TheSupremeMonkey/AMC-6502/docs/hardware/photos/mos-6502.jpg

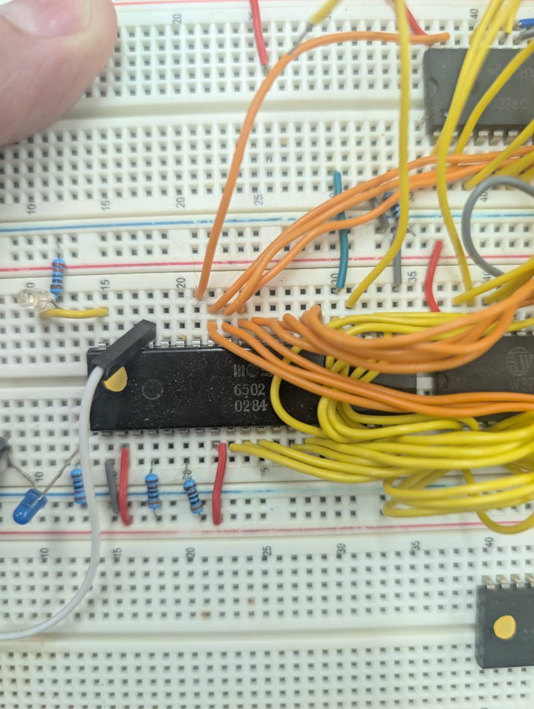
docs/hardware/photos/mos-6502.jpg
