TheSupremeMonkey/AMC-6502/docs/hardware/photos/mos-6522.jpg

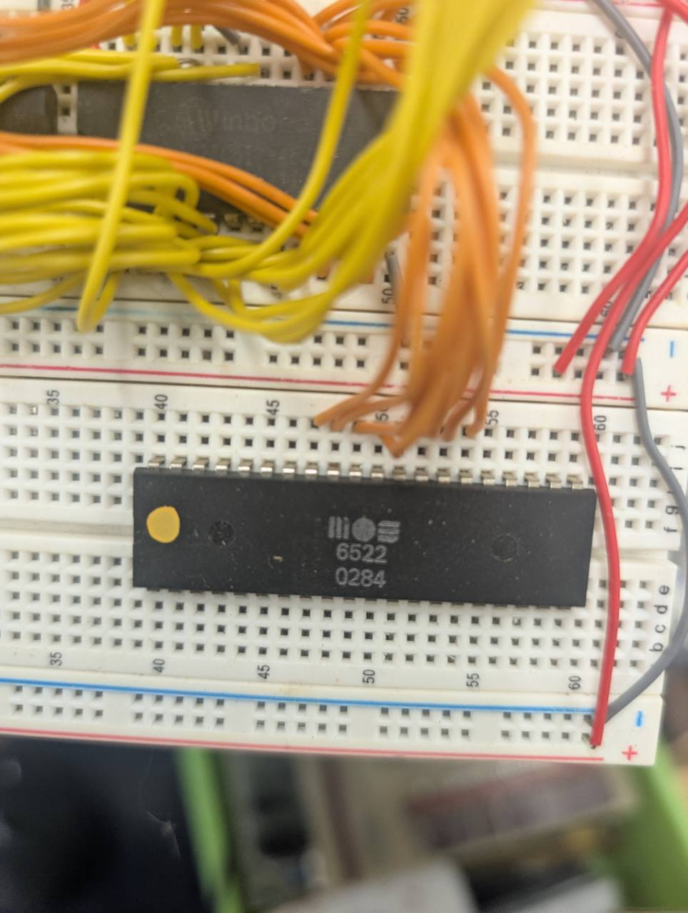
docs/hardware/photos/mos-6522.jpg
