TheSupremeMonkey/AMC-6502/docs/hardware/photos/w27c512-45z.jpg

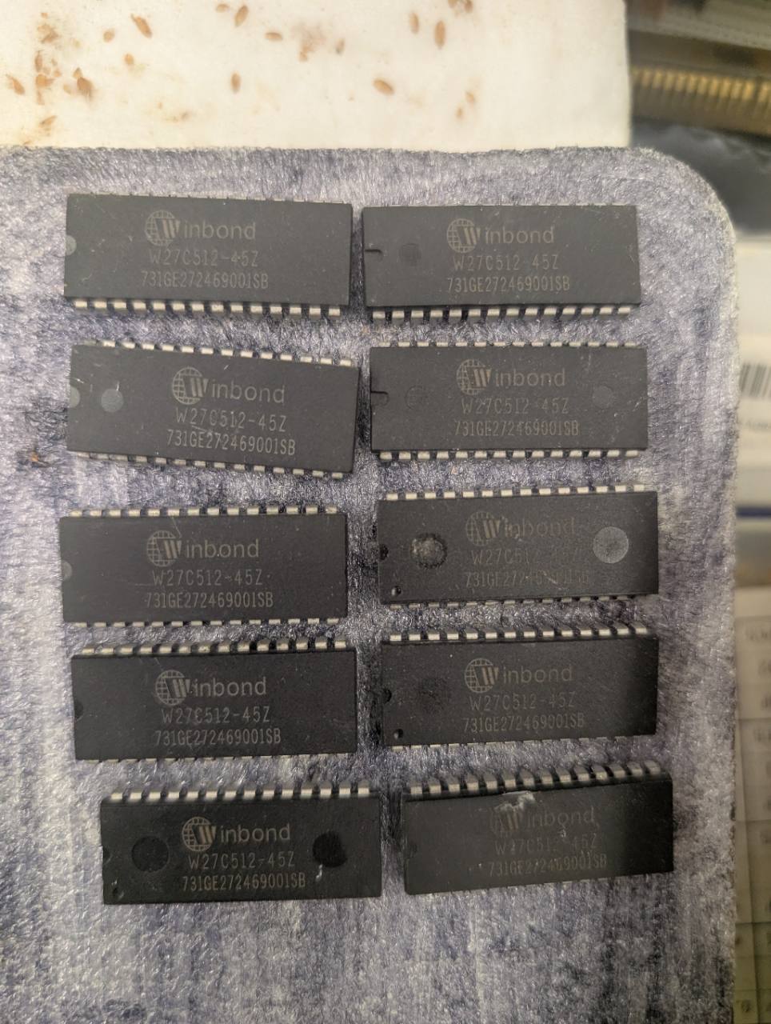
docs/hardware/photos/w27c512-45z.jpg
