TheSupremeMonkey/AMC-6502/hardware/kicad/01_CPU_Memory.kicad_sch

## KiCad design hardware/kicad/01_CPU_Memory.kicad_sch (2026-10-24)

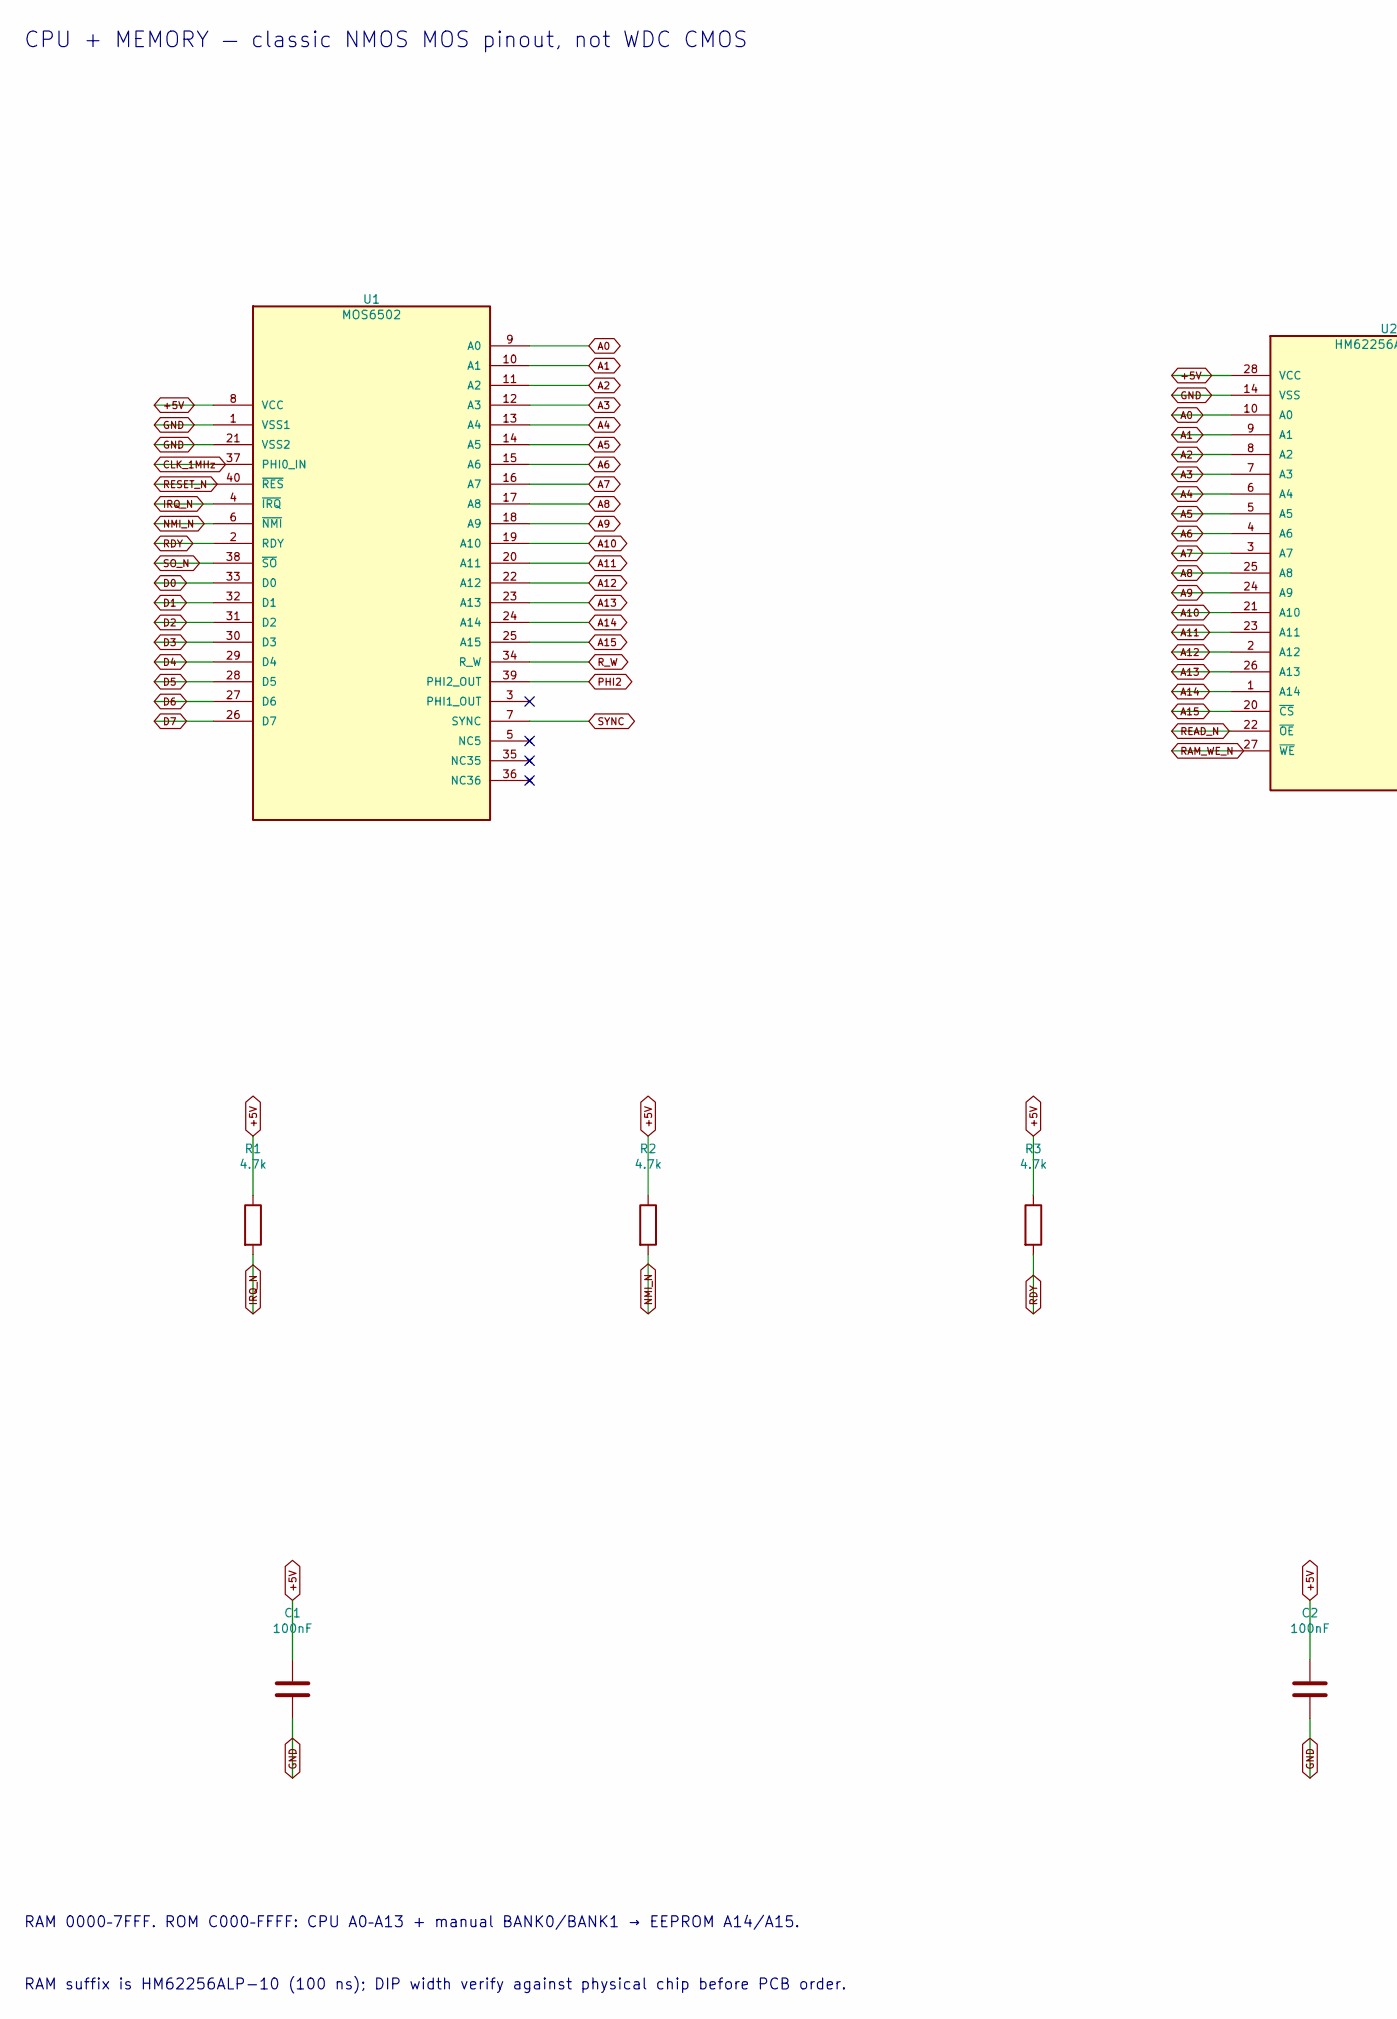
[picture p5: schematic 01_CPU_Memory.kicad_sch, part in row 1, column 1]

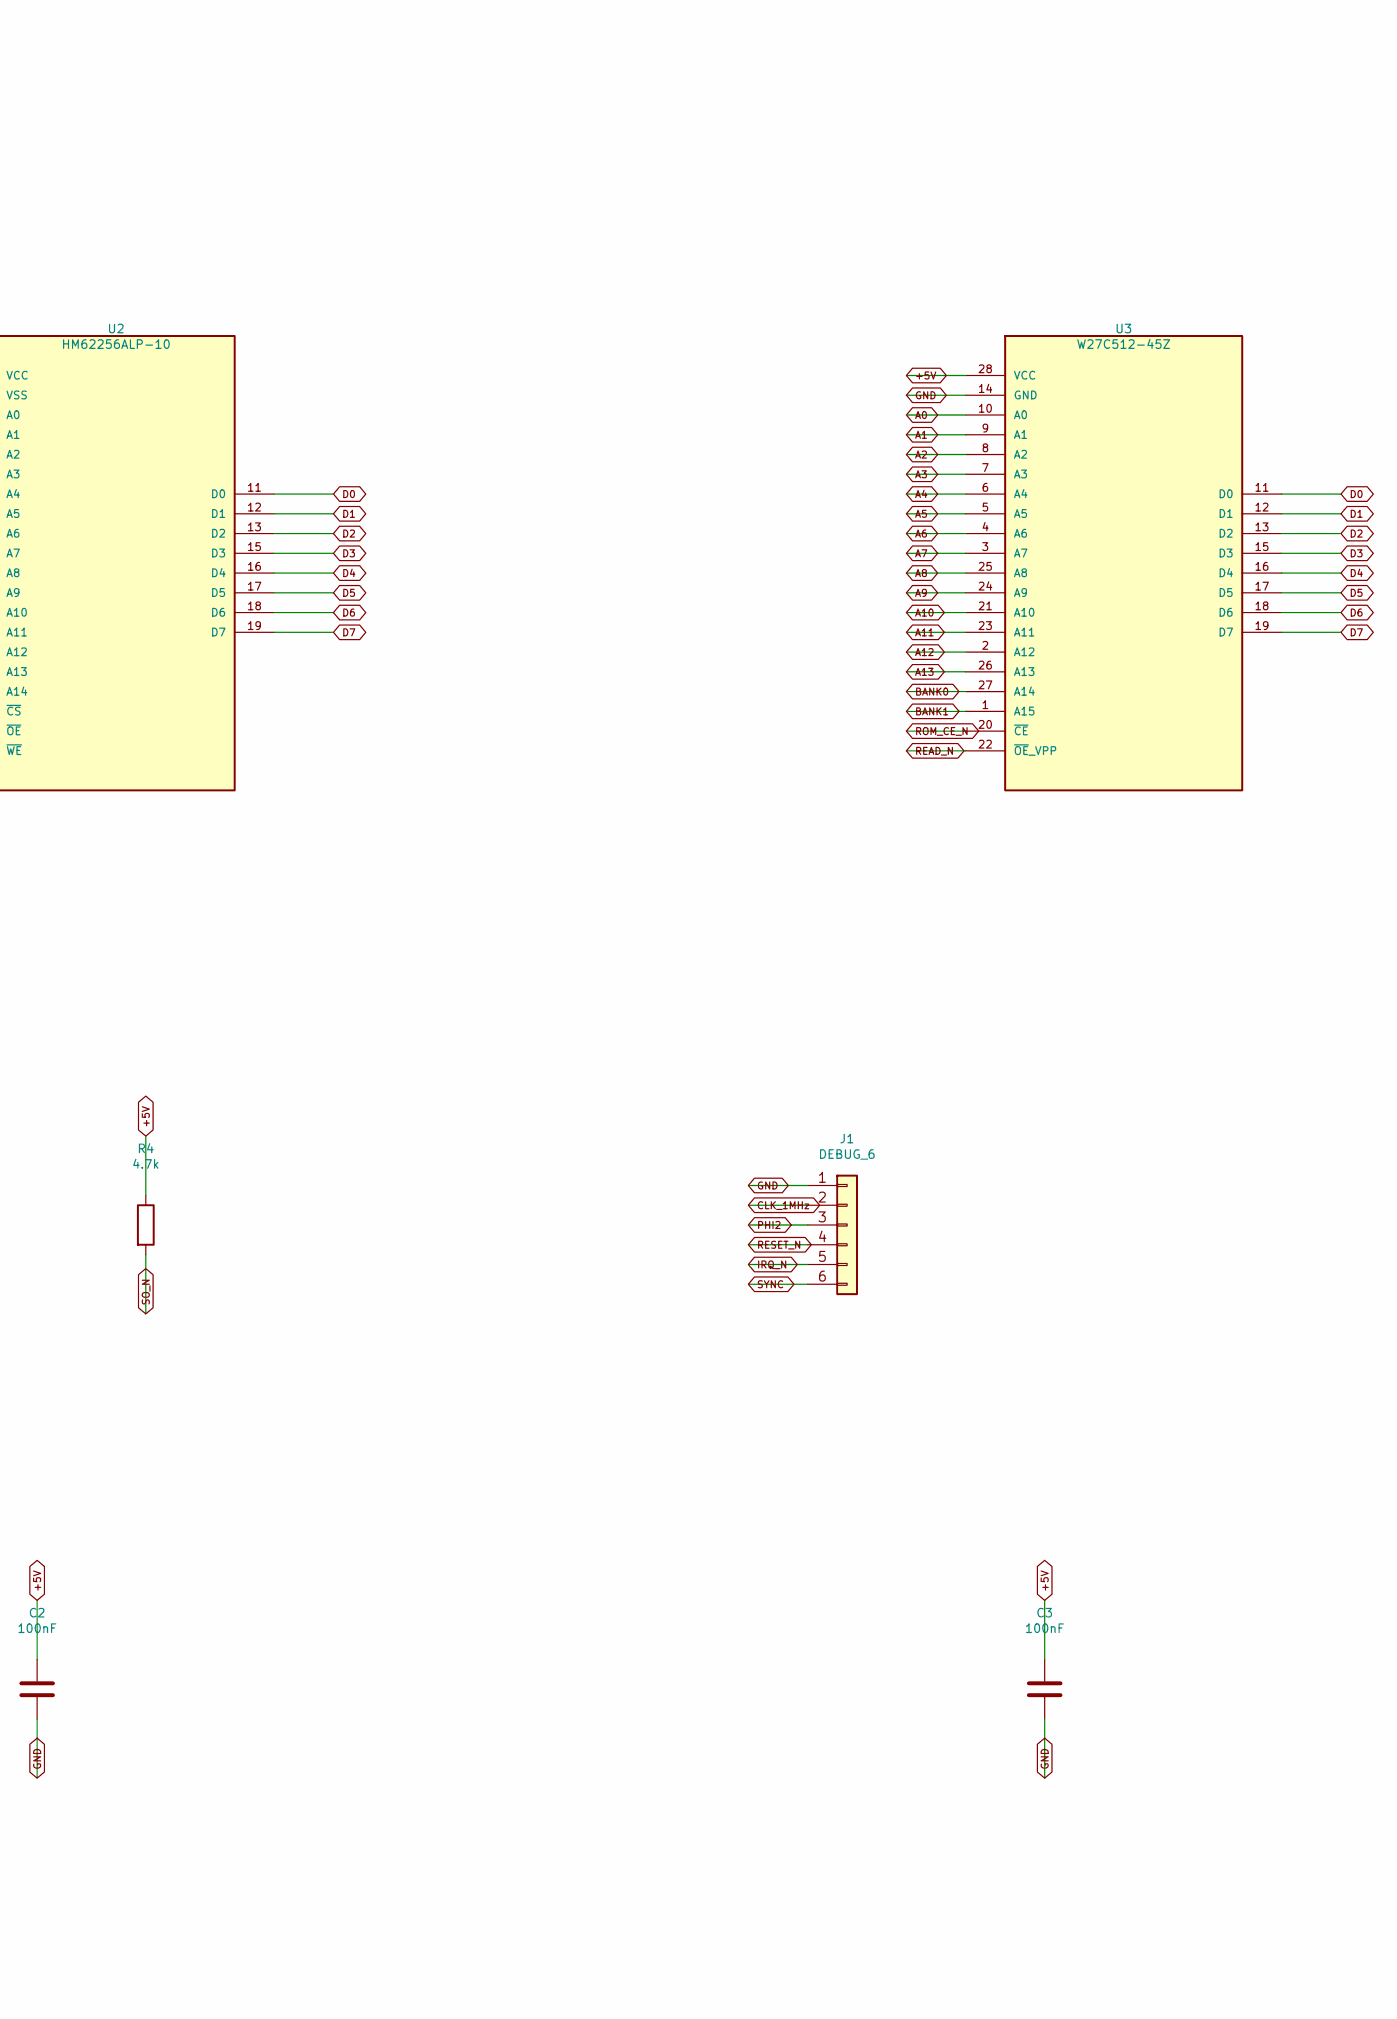
[picture p6: schematic 01_CPU_Memory.kicad_sch, part in row 1, column 2]

Parts:
C1, C2, C3: 100nF; C_Disc_D5.0mm_W2.5mm_P5.00mm
J1: DEBUG_6; PinHeader_1x06_P2.54mm_Vertical
R1, R2, R3, R4: 4.7k; R_Axial_DIN0207_L6.3mm_D2.5mm_P10.16mm_Horizontal
U1: MOS6502; DIP-40_W15.24mm_Socket
U2: HM62256ALP-10; DIP-28_W15.24mm_Socket
U3: W27C512-45Z; DIP-28_W15.24mm_Socket

Connections:
+5V: C1.1, C2.1, C3.1, R1.1, R2.1, R3.1, R4.1, U1.8 (VCC), U2.28 (VCC), U3.28 (VCC)
A0: U1.9 (A0), U2.10 (A0), U3.10 (A0)
A1: U1.10 (A1), U2.9 (A1), U3.9 (A1)
A2: U1.11 (A2), U2.8 (A2), U3.8 (A2)
A3: U1.12 (A3), U2.7 (A3), U3.7 (A3)
A4: U1.13 (A4), U2.6 (A4), U3.6 (A4)
A5: U1.14 (A5), U2.5 (A5), U3.5 (A5)
A6: U1.15 (A6), U2.4 (A6), U3.4 (A6)
A7: U1.16 (A7), U2.3 (A7), U3.3 (A7)
A8: U1.17 (A8), U2.25 (A8), U3.25 (A8)
A9: U1.18 (A9), U2.24 (A9), U3.24 (A9)
A10: U1.19 (A10), U2.21 (A10), U3.21 (A10)
A11: U1.20 (A11), U2.23 (A11), U3.23 (A11)
A12: U1.22 (A12), U2.2 (A12), U3.2 (A12)
A13: U1.23 (A13), U2.26 (A13), U3.26 (A13)
A14: U1.24 (A14), U2.1 (A14)
A15: U1.25 (A15), U2.20 (~CS)
BANK0: U3.27 (A14)
BANK1: U3.1 (A15)
CLK_1MHz: J1.2, U1.37 (PHI0_IN)
D0: U1.33 (D0), U2.11 (D0), U3.11 (D0)
D1: U1.32 (D1), U2.12 (D1), U3.12 (D1)
D2: U1.31 (D2), U2.13 (D2), U3.13 (D2)
D3: U1.30 (D3), U2.15 (D3), U3.15 (D3)
D4: U1.29 (D4), U2.16 (D4), U3.16 (D4)
D5: U1.28 (D5), U2.17 (D5), U3.17 (D5)
D6: U1.27 (D6), U2.18 (D6), U3.18 (D6)
D7: U1.26 (D7), U2.19 (D7), U3.19 (D7)
GND: C1.2, C2.2, C3.2, J1.1, U1.1 (VSS1), U1.21 (VSS2), U2.14 (VSS), U3.14 (GND)
IRQ_N: J1.5, R1.2, U1.4 (~IRQ)
NMI_N: R2.2, U1.6 (~NMI)
PHI2: J1.3, U1.39 (PHI2_OUT)
RAM_WE_N: U2.27 (~WE)
RDY: R3.2, U1.2 (RDY)
READ_N: U2.22 (~OE), U3.22 (~OE_VPP)
RESET_N: J1.4, U1.40 (~RES)
ROM_CE_N: U3.20 (~CE)
R_W: U1.34 (R_W)
SO_N: R4.2, U1.38 (~SO)
SYNC: J1.6, U1.7 (SYNC)

Notes on the sheet:
CPU + MEMORY — classic NMOS MOS pinout, not WDC CMOS
RAM 0000–7FFF. ROM C000–FFFF: CPU A0–A13 + manual BANK0/BANK1 → EEPROM A14/A15.
RAM suffix is HM62256ALP-10 (100 ns); DIP width verify against physical chip before PCB order.
