TheSupremeMonkey/AMC-6502/hardware/kicad/02_Decode_Clock_Reset.kicad_sch

## KiCad design hardware/kicad/02_Decode_Clock_Reset.kicad_sch (2026-10-24)

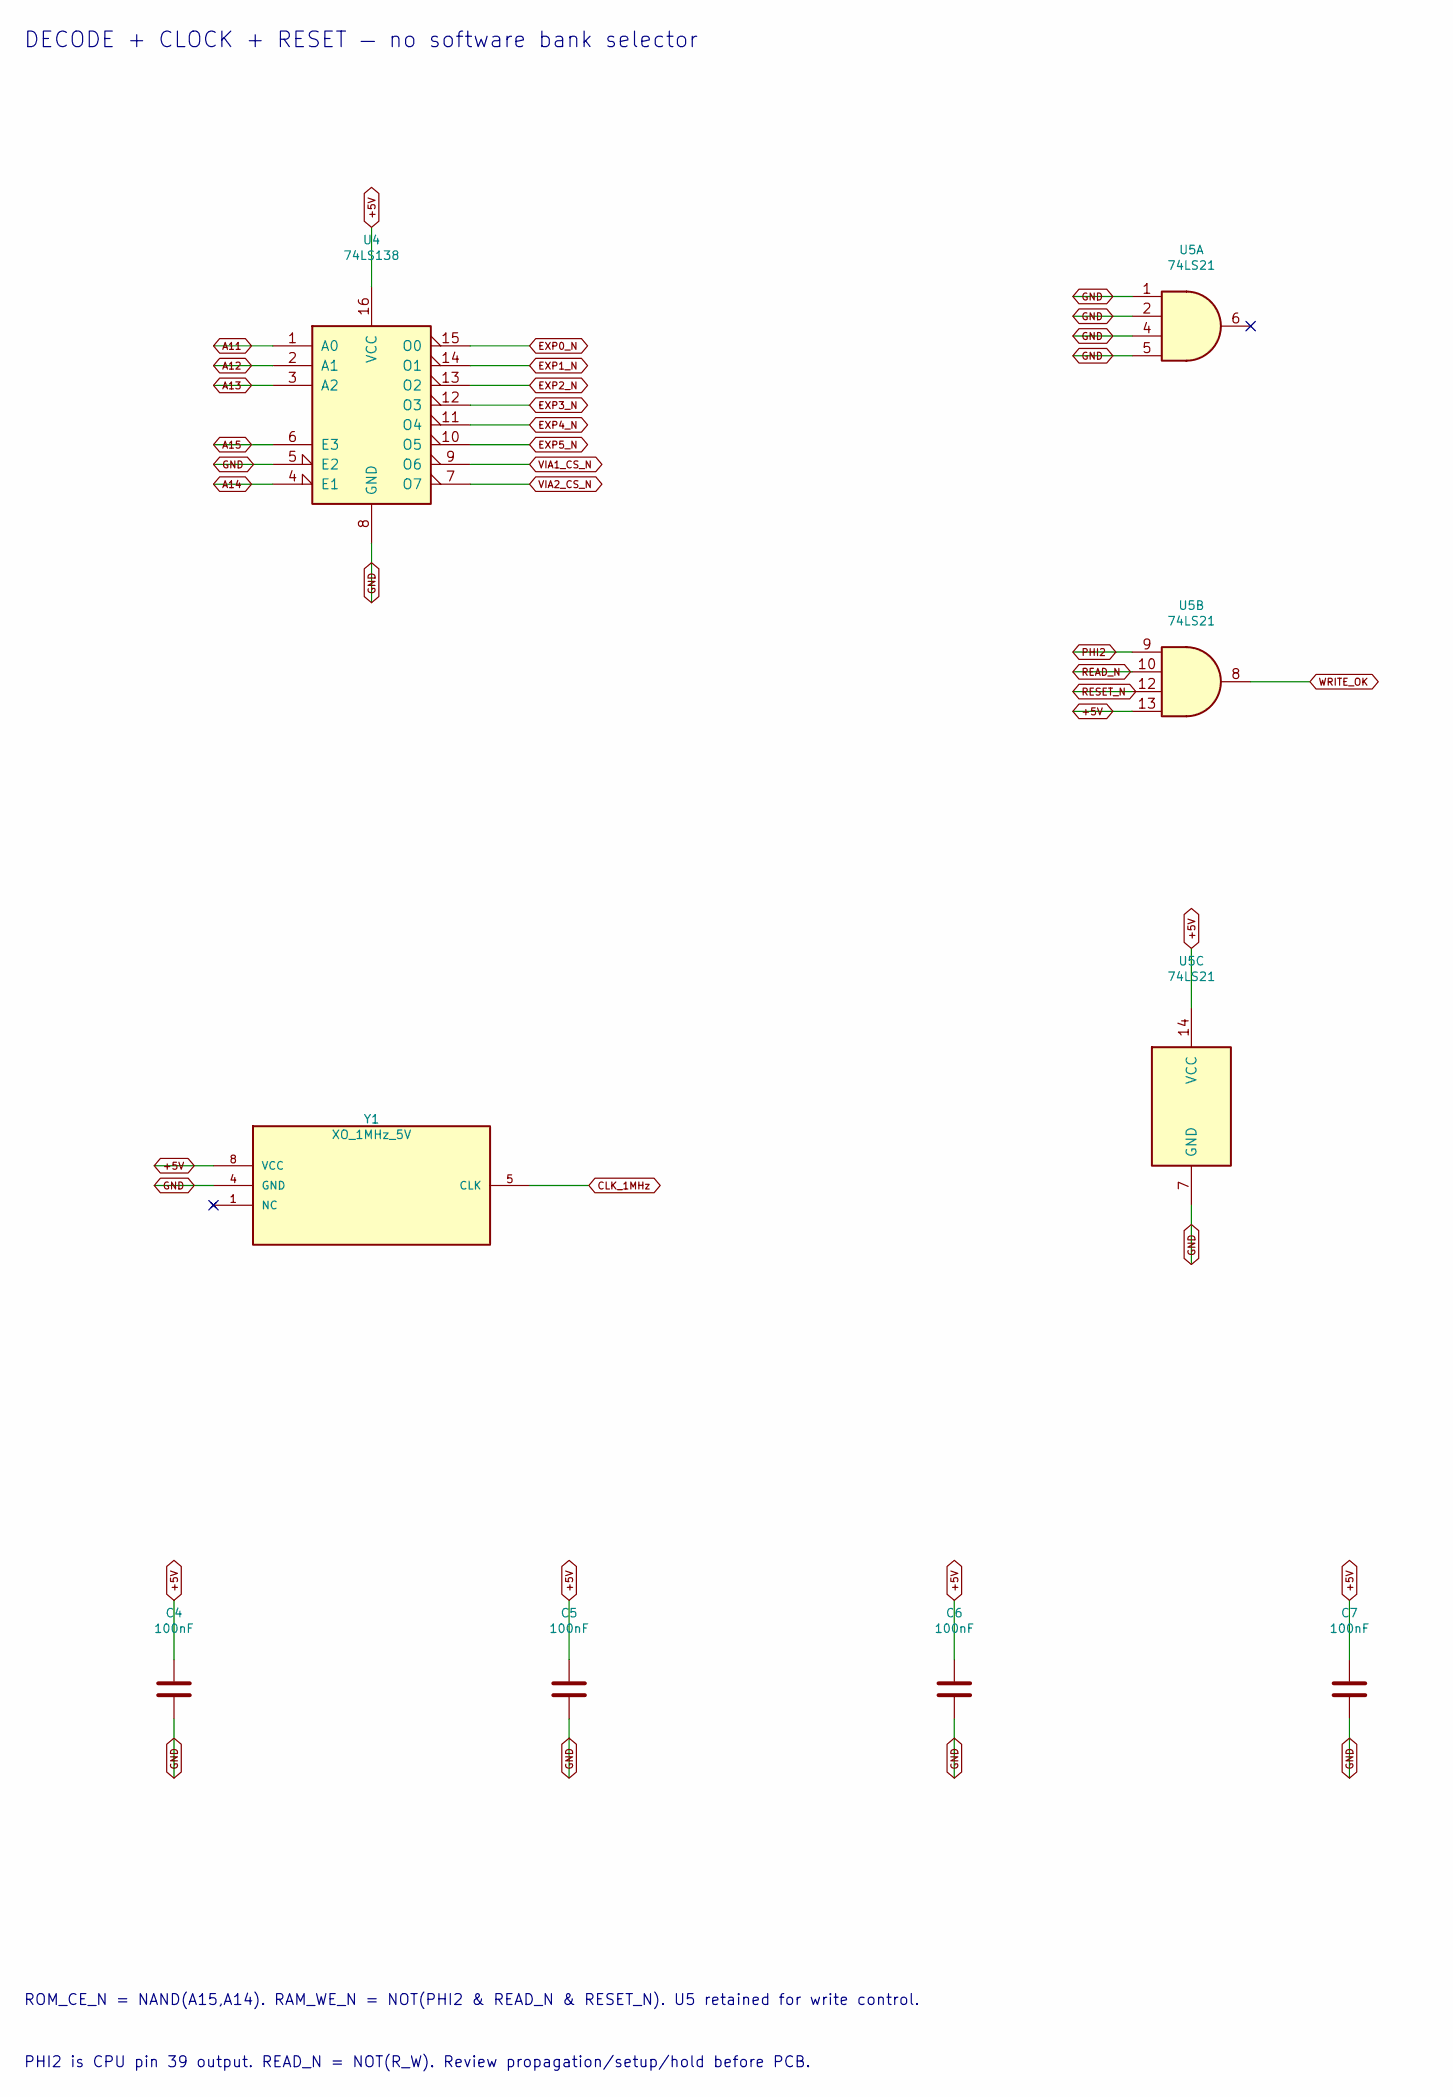
[picture p7: schematic 02_Decode_Clock_Reset.kicad_sch, part in row 1, column 1]

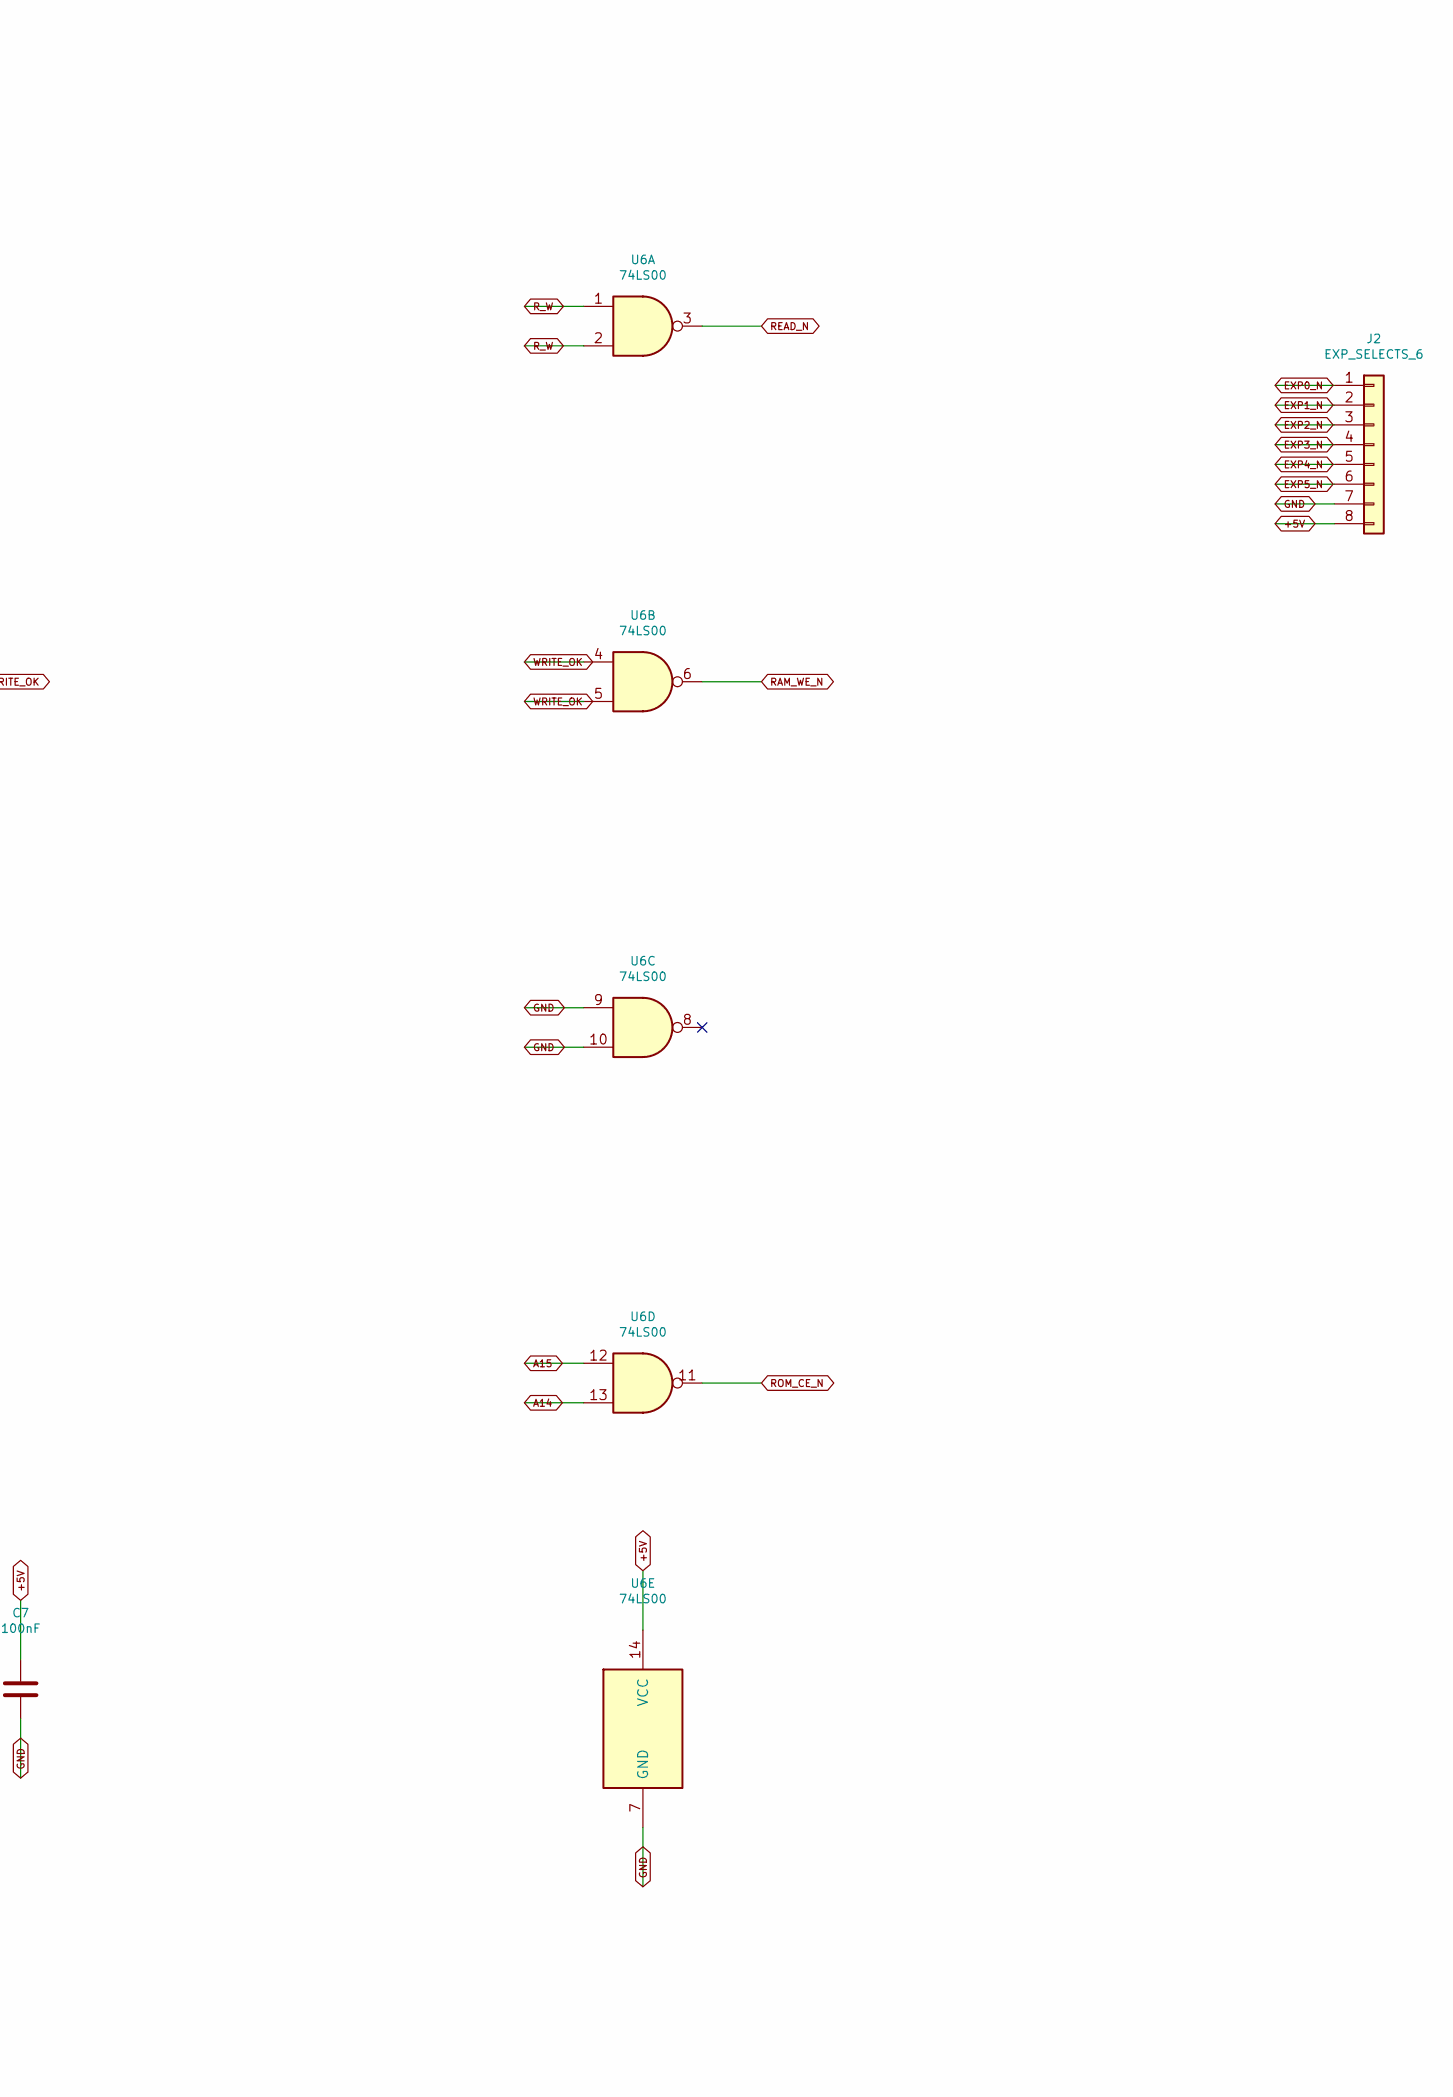
[picture p8: schematic 02_Decode_Clock_Reset.kicad_sch, part in row 1, column 2]

Parts:
C4, C5, C6, C7: 100nF; C_Disc_D5.0mm_W2.5mm_P5.00mm
J2: EXP_SELECTS_6; PinHeader_1x08_P2.54mm_Vertical
U4: 74LS138; DIP-16_W7.62mm_Socket
U5: 74LS21; DIP-14_W7.62mm_Socket
U6: 74LS00; DIP-14_W7.62mm_Socket
Y1: XO_1MHz_5V; Oscillator_DIP-8

Connections:
+5V: C4.1, C5.1, C6.1, C7.1, J2.8, U4.16 (VCC), U5.13, U5.14 (VCC), U6.14 (VCC), Y1.8 (VCC)
A11: U4.1 (A0)
A12: U4.2 (A1)
A13: U4.3 (A2)
A14: U4.4 (E1), U6.13
A15: U4.6 (E3), U6.12
CLK_1MHz: Y1.5 (CLK)
EXP0_N: J2.1, U4.15 (O0)
EXP1_N: J2.2, U4.14 (O1)
EXP2_N: J2.3, U4.13 (O2)
EXP3_N: J2.4, U4.12 (O3)
EXP4_N: J2.5, U4.11 (O4)
EXP5_N: J2.6, U4.10 (O5)
GND: C4.2, C5.2, C6.2, C7.2, J2.7, U4.5 (E2), U4.8 (GND), U5.1, U5.2, U5.4, U5.5, U5.7 (GND), U6.7 (GND), U6.9, U6.10, Y1.4 (GND)
PHI2: U5.9
RAM_WE_N: U6.6
READ_N: U5.10, U6.3
RESET_N: U5.12
ROM_CE_N: U6.11
R_W: U6.1, U6.2
VIA1_CS_N: U4.9 (O6)
VIA2_CS_N: U4.7 (O7)
WRITE_OK: U5.8, U6.4, U6.5

Notes on the sheet:
DECODE + CLOCK + RESET — no software bank selector
ROM_CE_N = NAND(A15,A14). RAM_WE_N = NOT(PHI2 & READ_N & RESET_N). U5 retained for write control.
PHI2 is CPU pin 39 output. READ_N = NOT(R_W). Review propagation/setup/hold before PCB.
