TheSupremeMonkey/AMC-6502/hardware/kicad/03_Reset_Controls.kicad_sch

## KiCad design hardware/kicad/03_Reset_Controls.kicad_sch (2026-10-24)

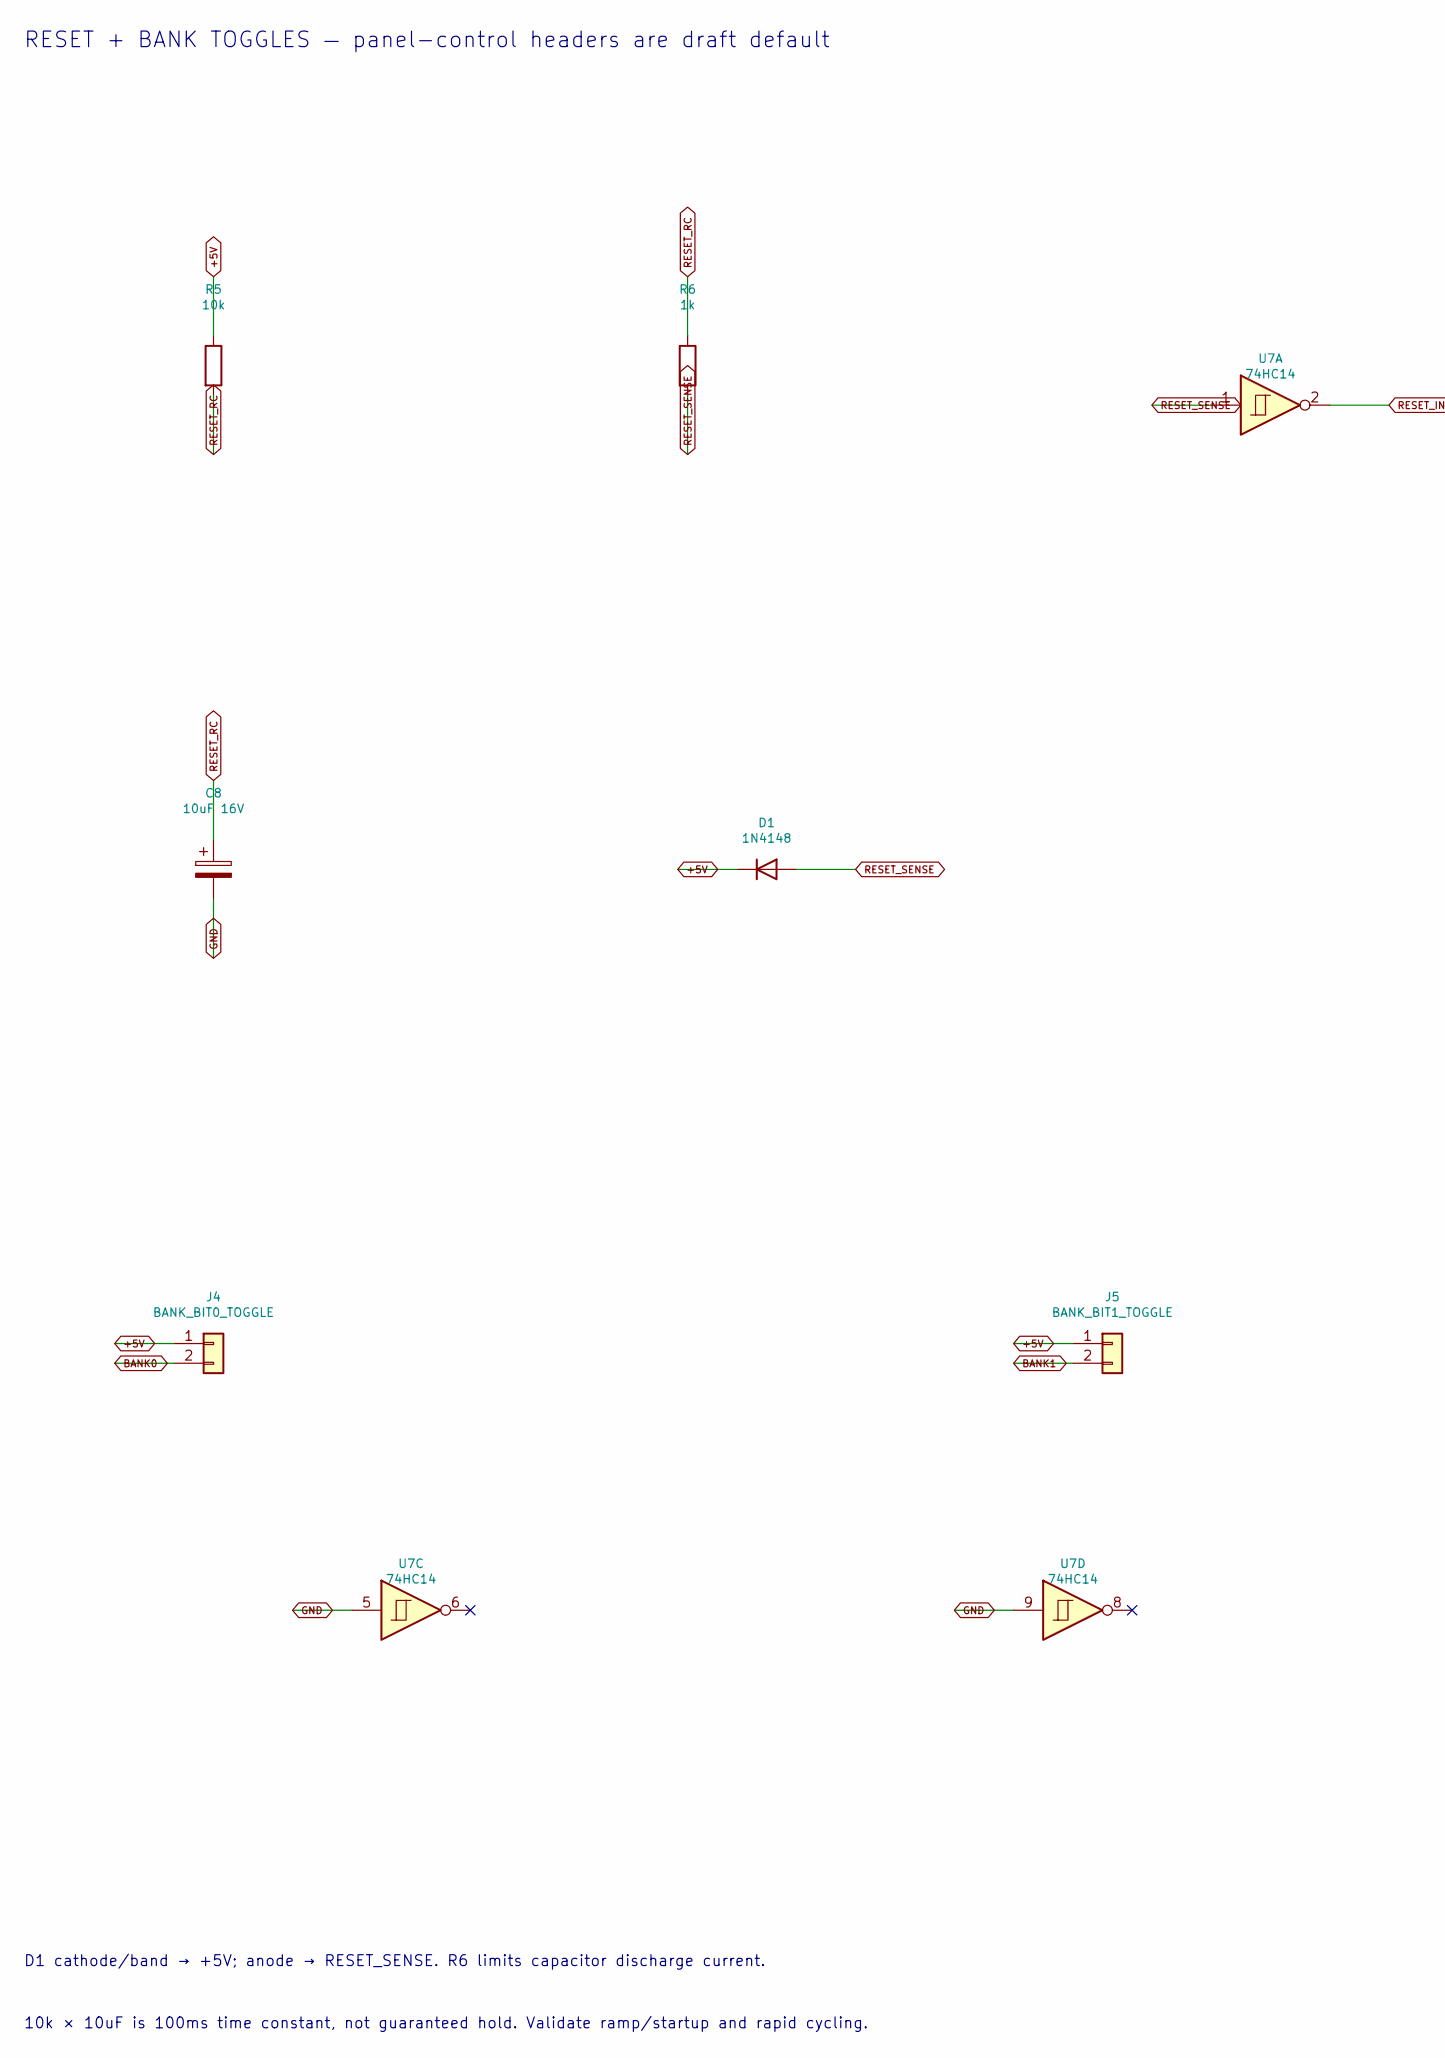
[picture p9: schematic 03_Reset_Controls.kicad_sch, part in row 1, column 1]

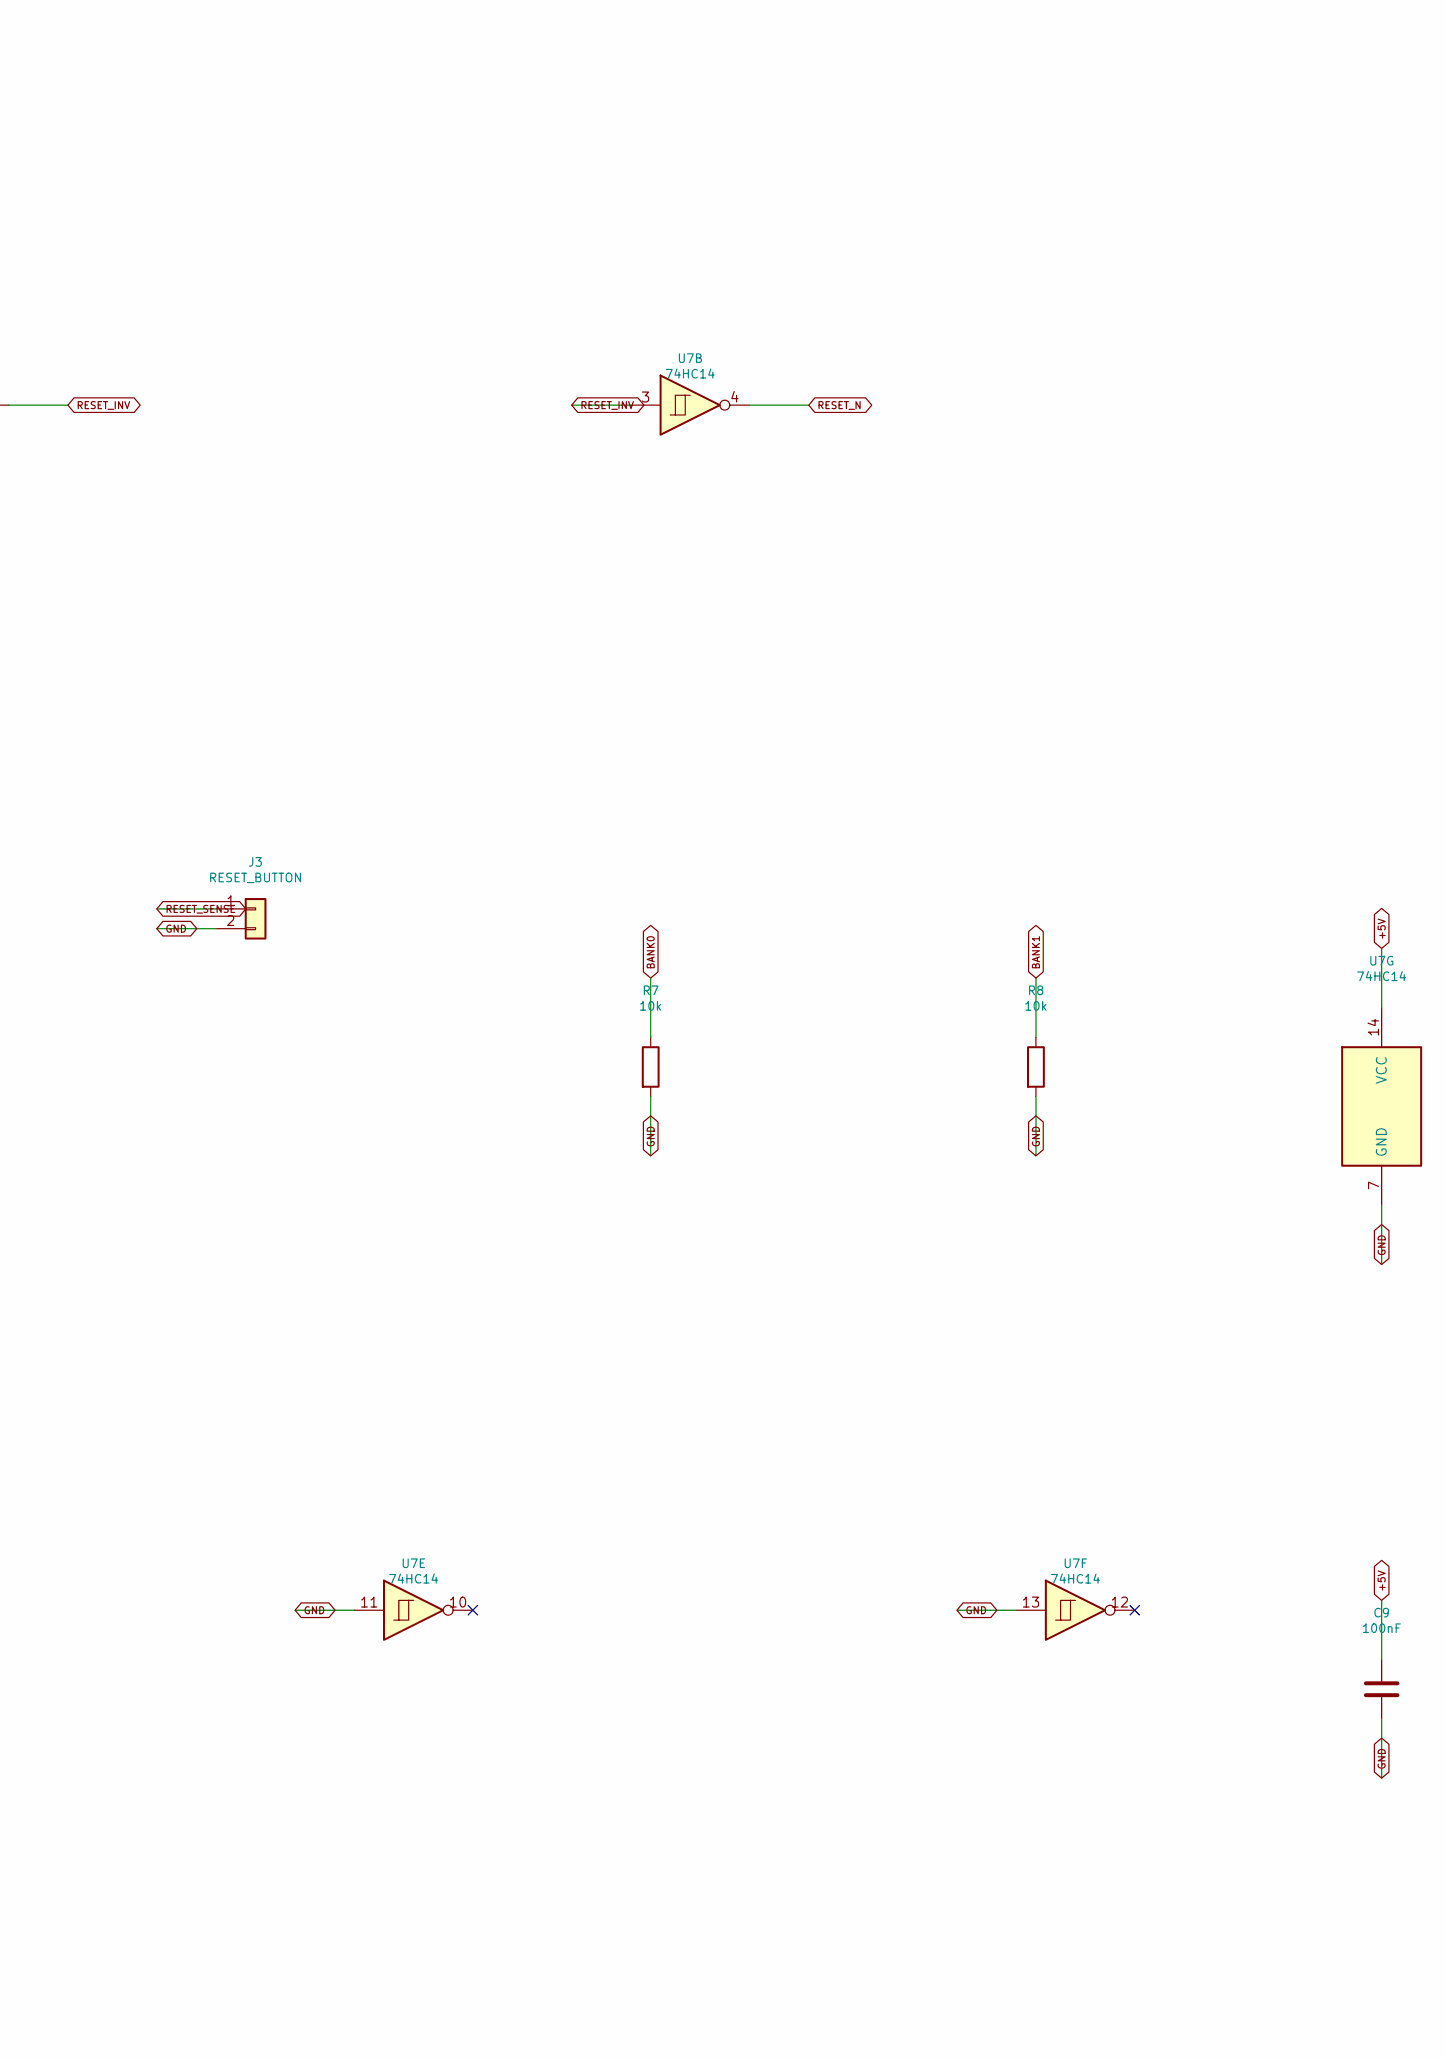
[picture p10: schematic 03_Reset_Controls.kicad_sch, part in row 1, column 2]

Parts:
C8: 10uF 16V; CP_Radial_D5.0mm_P2.00mm
C9: 100nF; C_Disc_D5.0mm_W2.5mm_P5.00mm
D1: 1N4148; D_DO-35_SOD27_P10.16mm_Horizontal
J3: RESET_BUTTON; PinHeader_1x02_P2.54mm_Vertical
J4: BANK_BIT0_TOGGLE; PinHeader_1x02_P2.54mm_Vertical
J5: BANK_BIT1_TOGGLE; PinHeader_1x02_P2.54mm_Vertical
R5, R7, R8: 10k; R_Axial_DIN0207_L6.3mm_D2.5mm_P10.16mm_Horizontal
R6: 1k; R_Axial_DIN0207_L6.3mm_D2.5mm_P10.16mm_Horizontal
U7: 74HC14; DIP-14_W7.62mm_Socket

Connections:
+5V: C9.1, D1.1 (K), J4.1, J5.1, R5.1, U7.14 (VCC)
BANK0: J4.2, R7.1
BANK1: J5.2, R8.1
GND: C8.2, C9.2, J3.2, R7.2, R8.2, U7.5, U7.7 (GND), U7.9, U7.11, U7.13
RESET_INV: U7.2, U7.3
RESET_N: U7.4
RESET_RC: C8.1, R5.2, R6.1
RESET_SENSE: D1.2 (A), J3.1, R6.2, U7.1

Notes on the sheet:
RESET + BANK TOGGLES — panel-control headers are draft default
D1 cathode/band → +5V; anode → RESET_SENSE. R6 limits capacitor discharge current.
10k × 10uF is 100ms time constant, not guaranteed hold. Validate ramp/startup and rapid cycling.
