TheSupremeMonkey/AMC-6502/hardware/kicad/04_VIA_IO.kicad_sch

## KiCad design hardware/kicad/04_VIA_IO.kicad_sch (2026-10-24)

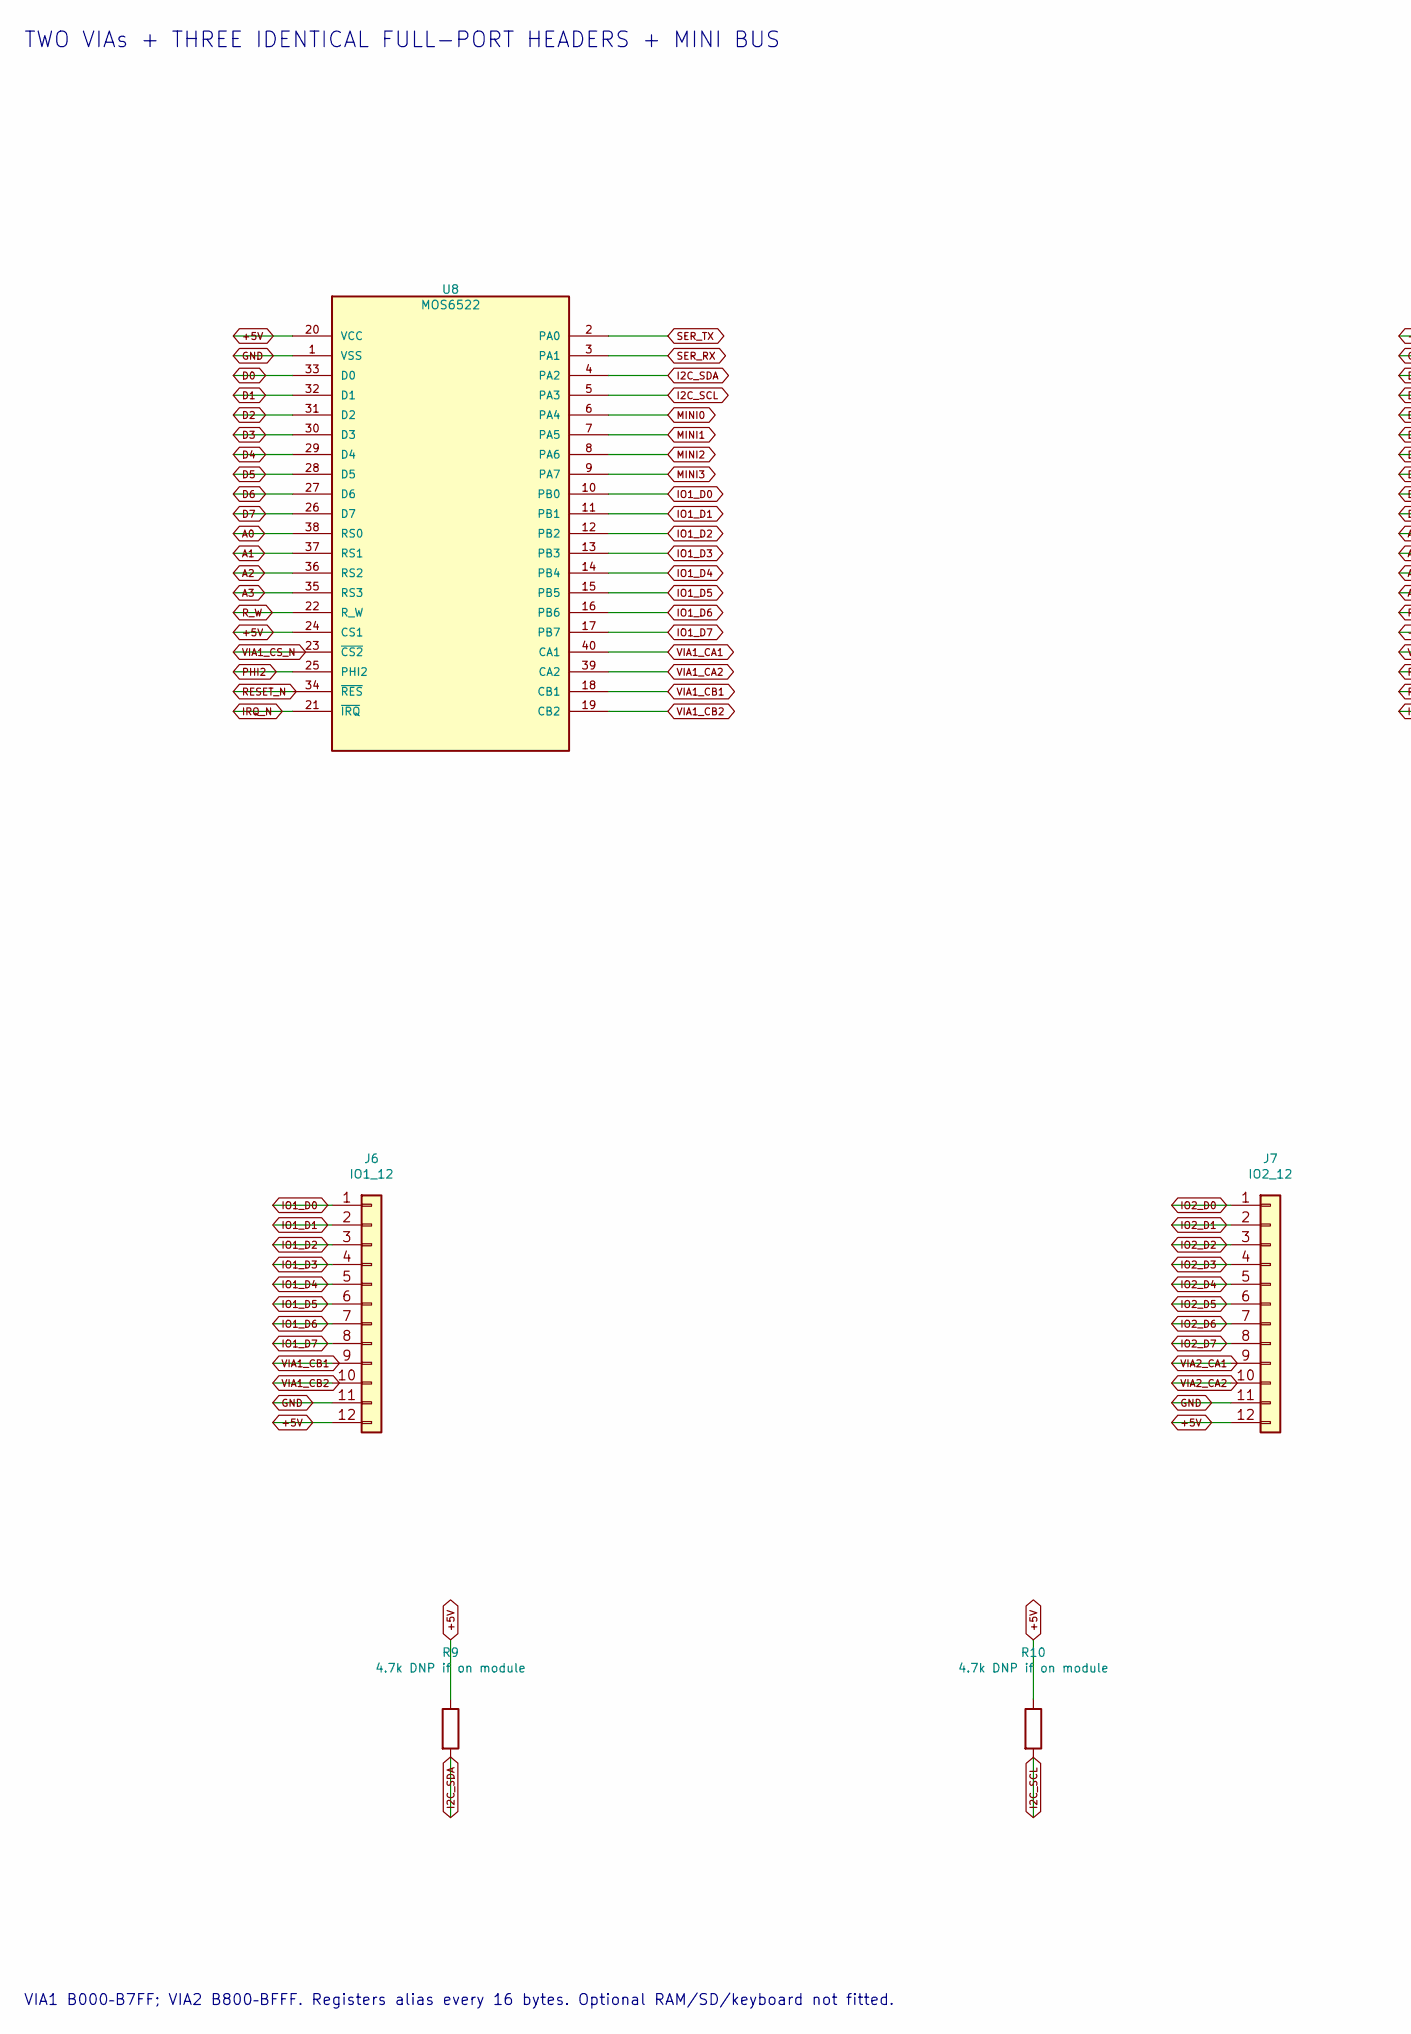
[picture p11: schematic 04_VIA_IO.kicad_sch, part in row 1, column 1]

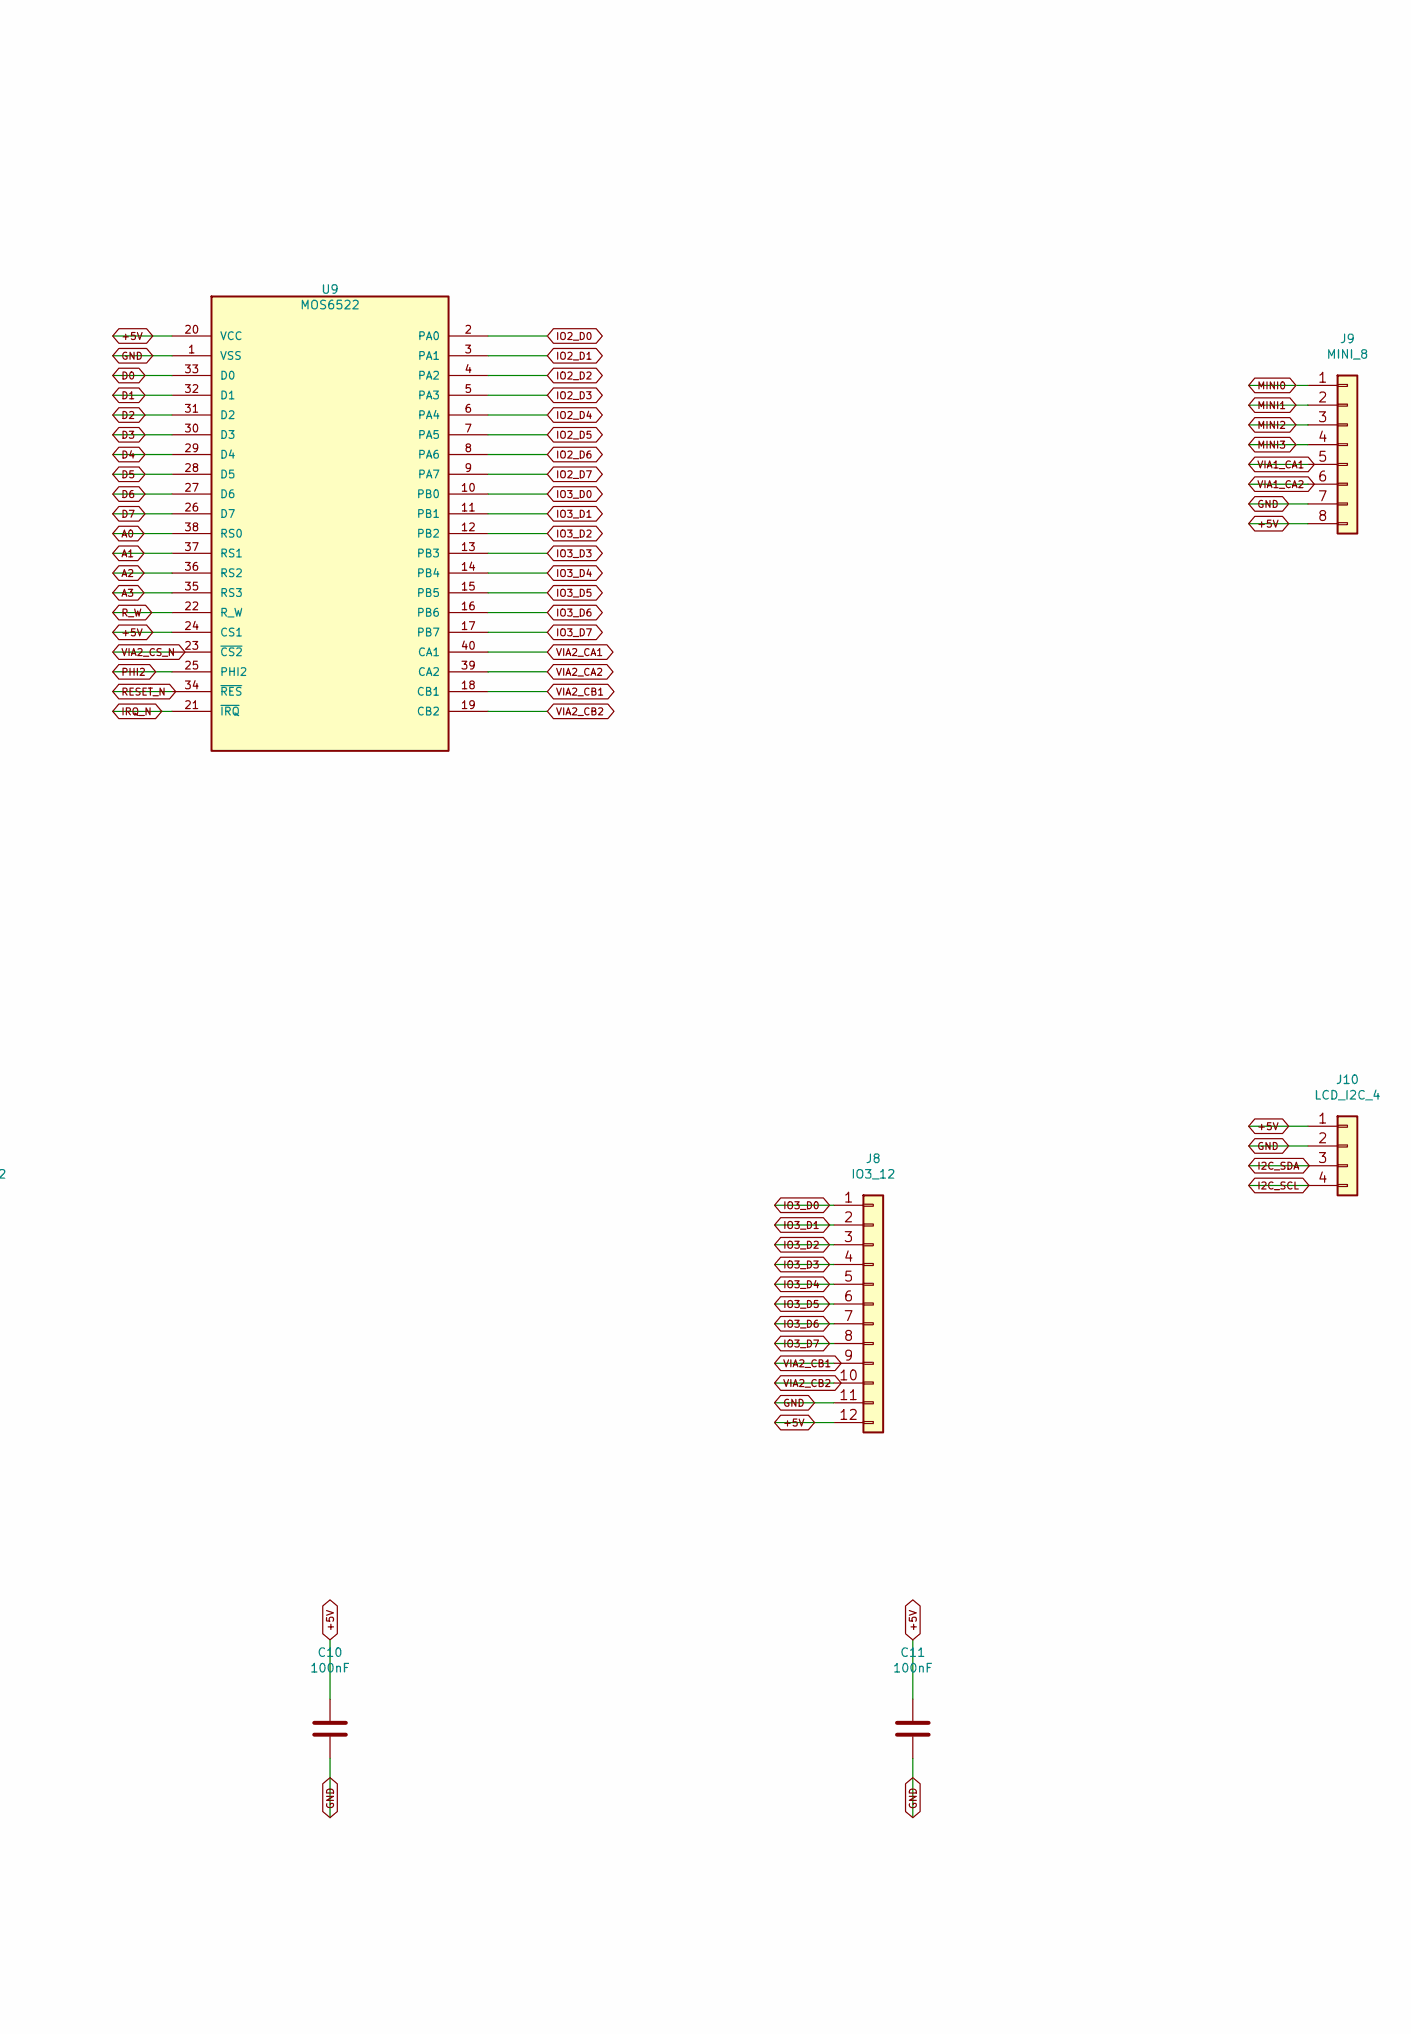
[picture p12: schematic 04_VIA_IO.kicad_sch, part in row 1, column 2]

Parts:
C10, C11: 100nF; C_Disc_D5.0mm_W2.5mm_P5.00mm
J6: IO1_12; PinHeader_1x12_P2.54mm_Vertical
J7: IO2_12; PinHeader_1x12_P2.54mm_Vertical
J8: IO3_12; PinHeader_1x12_P2.54mm_Vertical
J9: MINI_8; PinHeader_1x08_P2.54mm_Vertical
J10: LCD_I2C_4; PinHeader_1x04_P2.54mm_Vertical
R9, R10: 4.7k DNP if on module; R_Axial_DIN0207_L6.3mm_D2.5mm_P10.16mm_Horizontal
U8, U9: MOS6522; DIP-40_W15.24mm_Socket

Connections:
+5V: C10.1, C11.1, J6.12, J7.12, J8.12, J9.8, J10.1, R9.1, R10.1, U8.20 (VCC), U8.24 (CS1), U9.20 (VCC), U9.24 (CS1)
A0: U8.38 (RS0), U9.38 (RS0)
A1: U8.37 (RS1), U9.37 (RS1)
A2: U8.36 (RS2), U9.36 (RS2)
A3: U8.35 (RS3), U9.35 (RS3)
D0: U8.33 (D0), U9.33 (D0)
D1: U8.32 (D1), U9.32 (D1)
D2: U8.31 (D2), U9.31 (D2)
D3: U8.30 (D3), U9.30 (D3)
D4: U8.29 (D4), U9.29 (D4)
D5: U8.28 (D5), U9.28 (D5)
D6: U8.27 (D6), U9.27 (D6)
D7: U8.26 (D7), U9.26 (D7)
GND: C10.2, C11.2, J6.11, J7.11, J8.11, J9.7, J10.2, U8.1 (VSS), U9.1 (VSS)
I2C_SCL: J10.4, R10.2, U8.5 (PA3)
I2C_SDA: J10.3, R9.2, U8.4 (PA2)
IO1_D0: J6.1, U8.10 (PB0)
IO1_D1: J6.2, U8.11 (PB1)
IO1_D2: J6.3, U8.12 (PB2)
IO1_D3: J6.4, U8.13 (PB3)
IO1_D4: J6.5, U8.14 (PB4)
IO1_D5: J6.6, U8.15 (PB5)
IO1_D6: J6.7, U8.16 (PB6)
IO1_D7: J6.8, U8.17 (PB7)
IO2_D0: J7.1, U9.2 (PA0)
IO2_D1: J7.2, U9.3 (PA1)
IO2_D2: J7.3, U9.4 (PA2)
IO2_D3: J7.4, U9.5 (PA3)
IO2_D4: J7.5, U9.6 (PA4)
IO2_D5: J7.6, U9.7 (PA5)
IO2_D6: J7.7, U9.8 (PA6)
IO2_D7: J7.8, U9.9 (PA7)
IO3_D0: J8.1, U9.10 (PB0)
IO3_D1: J8.2, U9.11 (PB1)
IO3_D2: J8.3, U9.12 (PB2)
IO3_D3: J8.4, U9.13 (PB3)
IO3_D4: J8.5, U9.14 (PB4)
IO3_D5: J8.6, U9.15 (PB5)
IO3_D6: J8.7, U9.16 (PB6)
IO3_D7: J8.8, U9.17 (PB7)
IRQ_N: U8.21 (~IRQ), U9.21 (~IRQ)
MINI0: J9.1, U8.6 (PA4)
MINI1: J9.2, U8.7 (PA5)
MINI2: J9.3, U8.8 (PA6)
MINI3: J9.4, U8.9 (PA7)
PHI2: U8.25 (PHI2), U9.25 (PHI2)
RESET_N: U8.34 (~RES), U9.34 (~RES)
R_W: U8.22 (R_W), U9.22 (R_W)
SER_RX: U8.3 (PA1)
SER_TX: U8.2 (PA0)
VIA1_CA1: J9.5, U8.40 (CA1)
VIA1_CA2: J9.6, U8.39 (CA2)
VIA1_CB1: J6.9, U8.18 (CB1)
VIA1_CB2: J6.10, U8.19 (CB2)
VIA1_CS_N: U8.23 (~CS2)
VIA2_CA1: J7.9, U9.40 (CA1)
VIA2_CA2: J7.10, U9.39 (CA2)
VIA2_CB1: J8.9, U9.18 (CB1)
VIA2_CB2: J8.10, U9.19 (CB2)
VIA2_CS_N: U9.23 (~CS2)

Notes on the sheet:
TWO VIAs + THREE IDENTICAL FULL-PORT HEADERS + MINI BUS
VIA1 B000–B7FF; VIA2 B800–BFFF. Registers alias every 16 bytes. Optional RAM/SD/keyboard not fitted.
