TheSupremeMonkey/AMC-6502/hardware/kicad/05_Power_Serial.kicad_sch

## KiCad design hardware/kicad/05_Power_Serial.kicad_sch (2026-10-24)

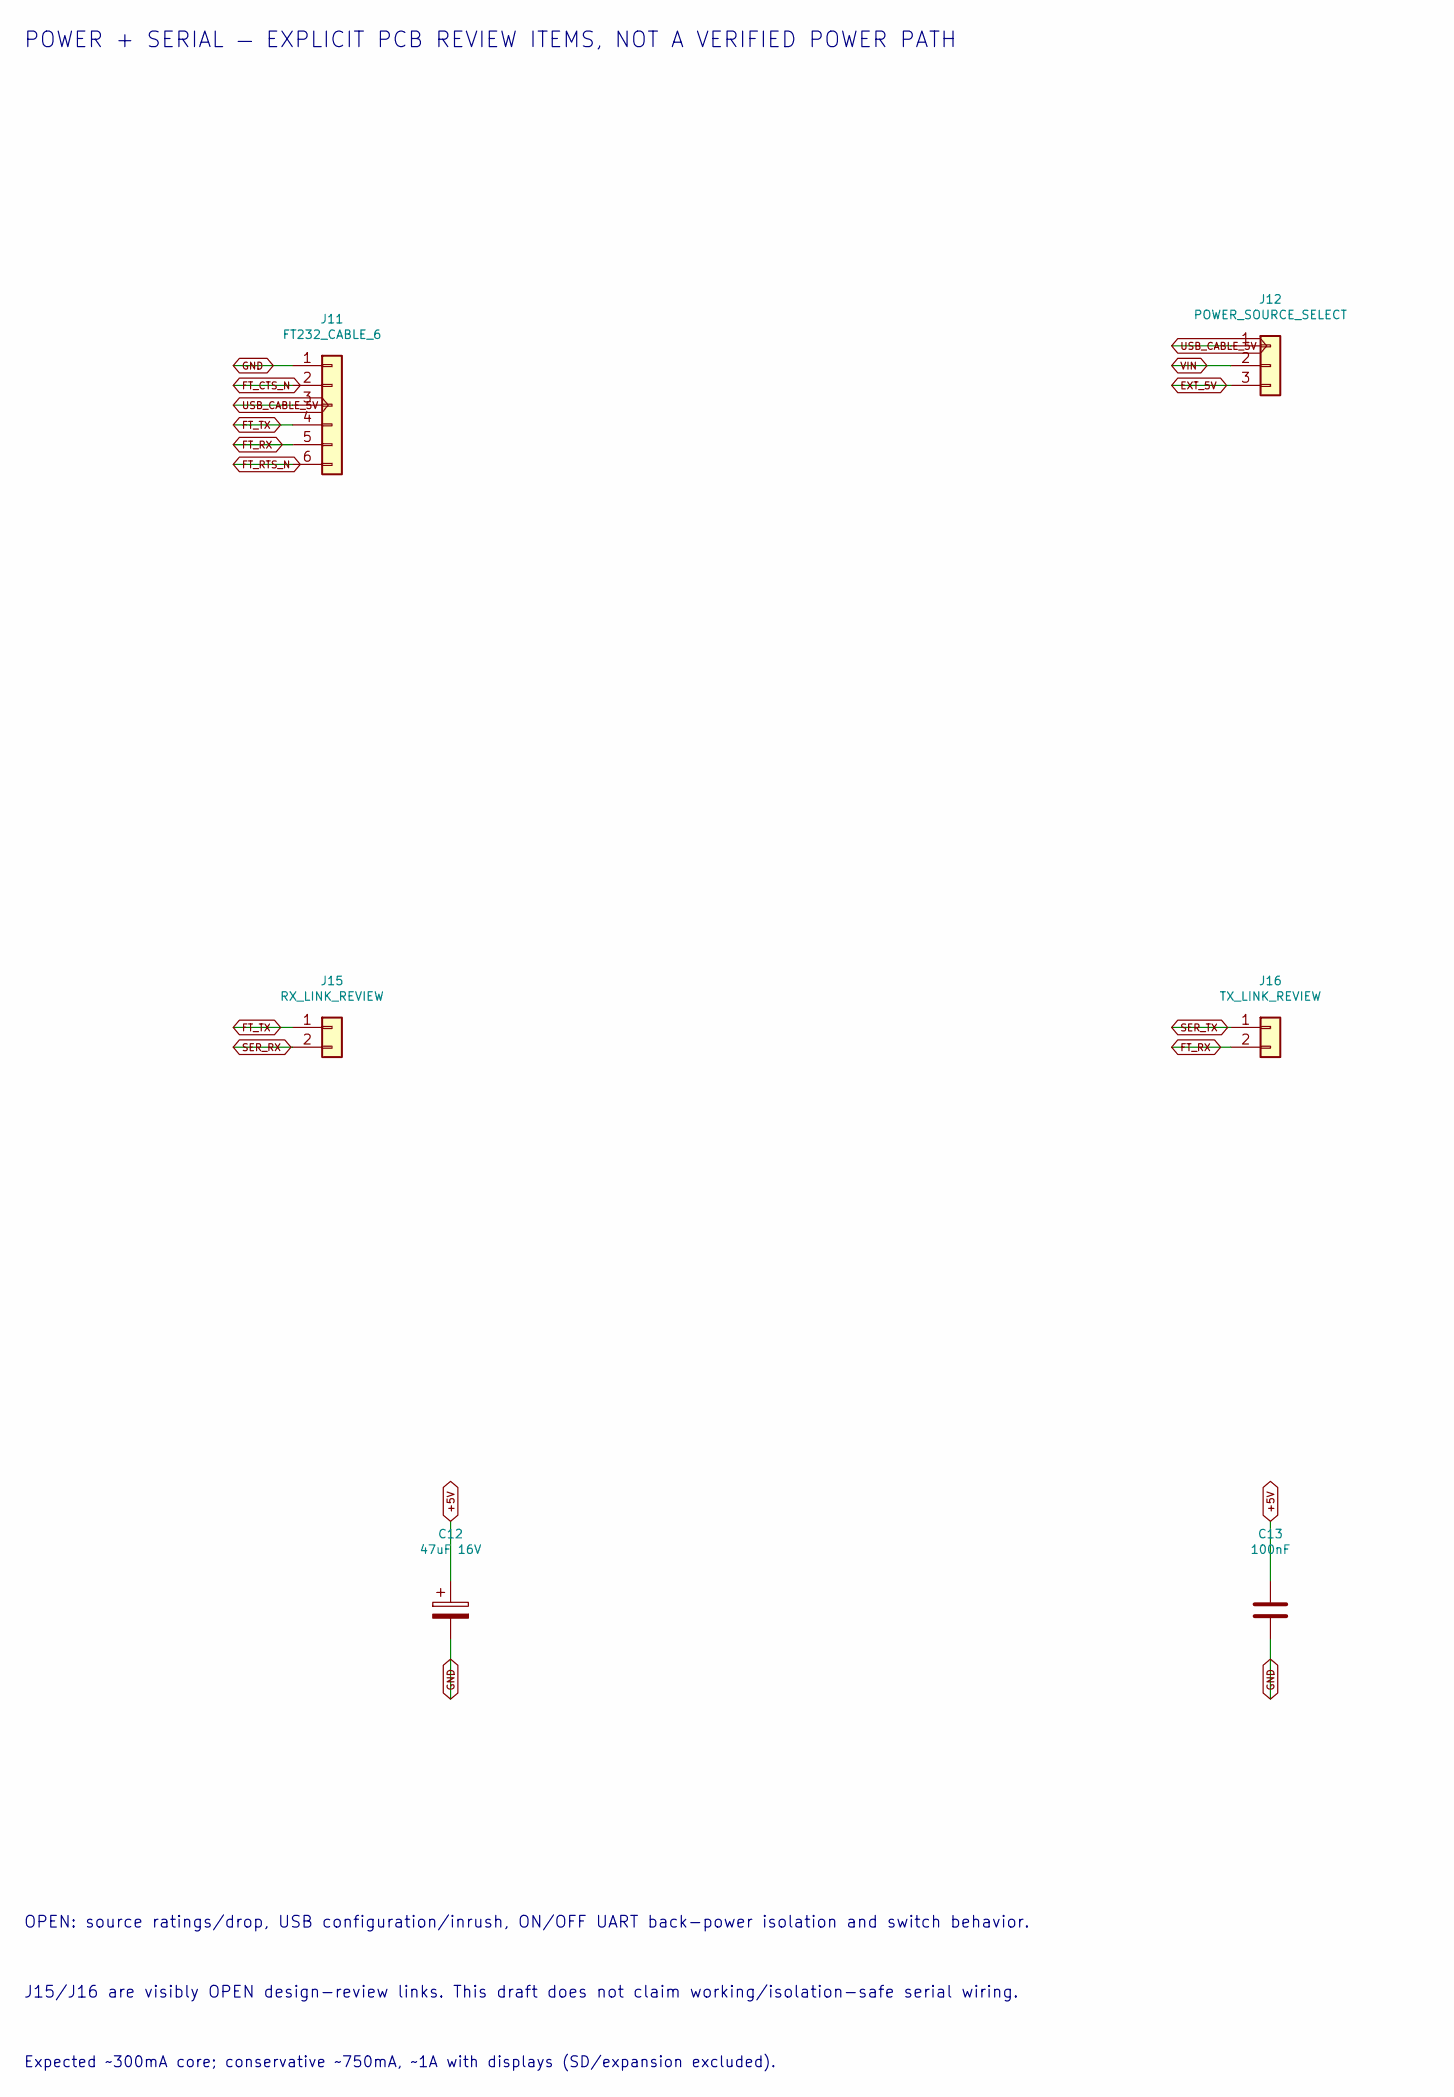
[picture p13: schematic 05_Power_Serial.kicad_sch, part in row 1, column 1]

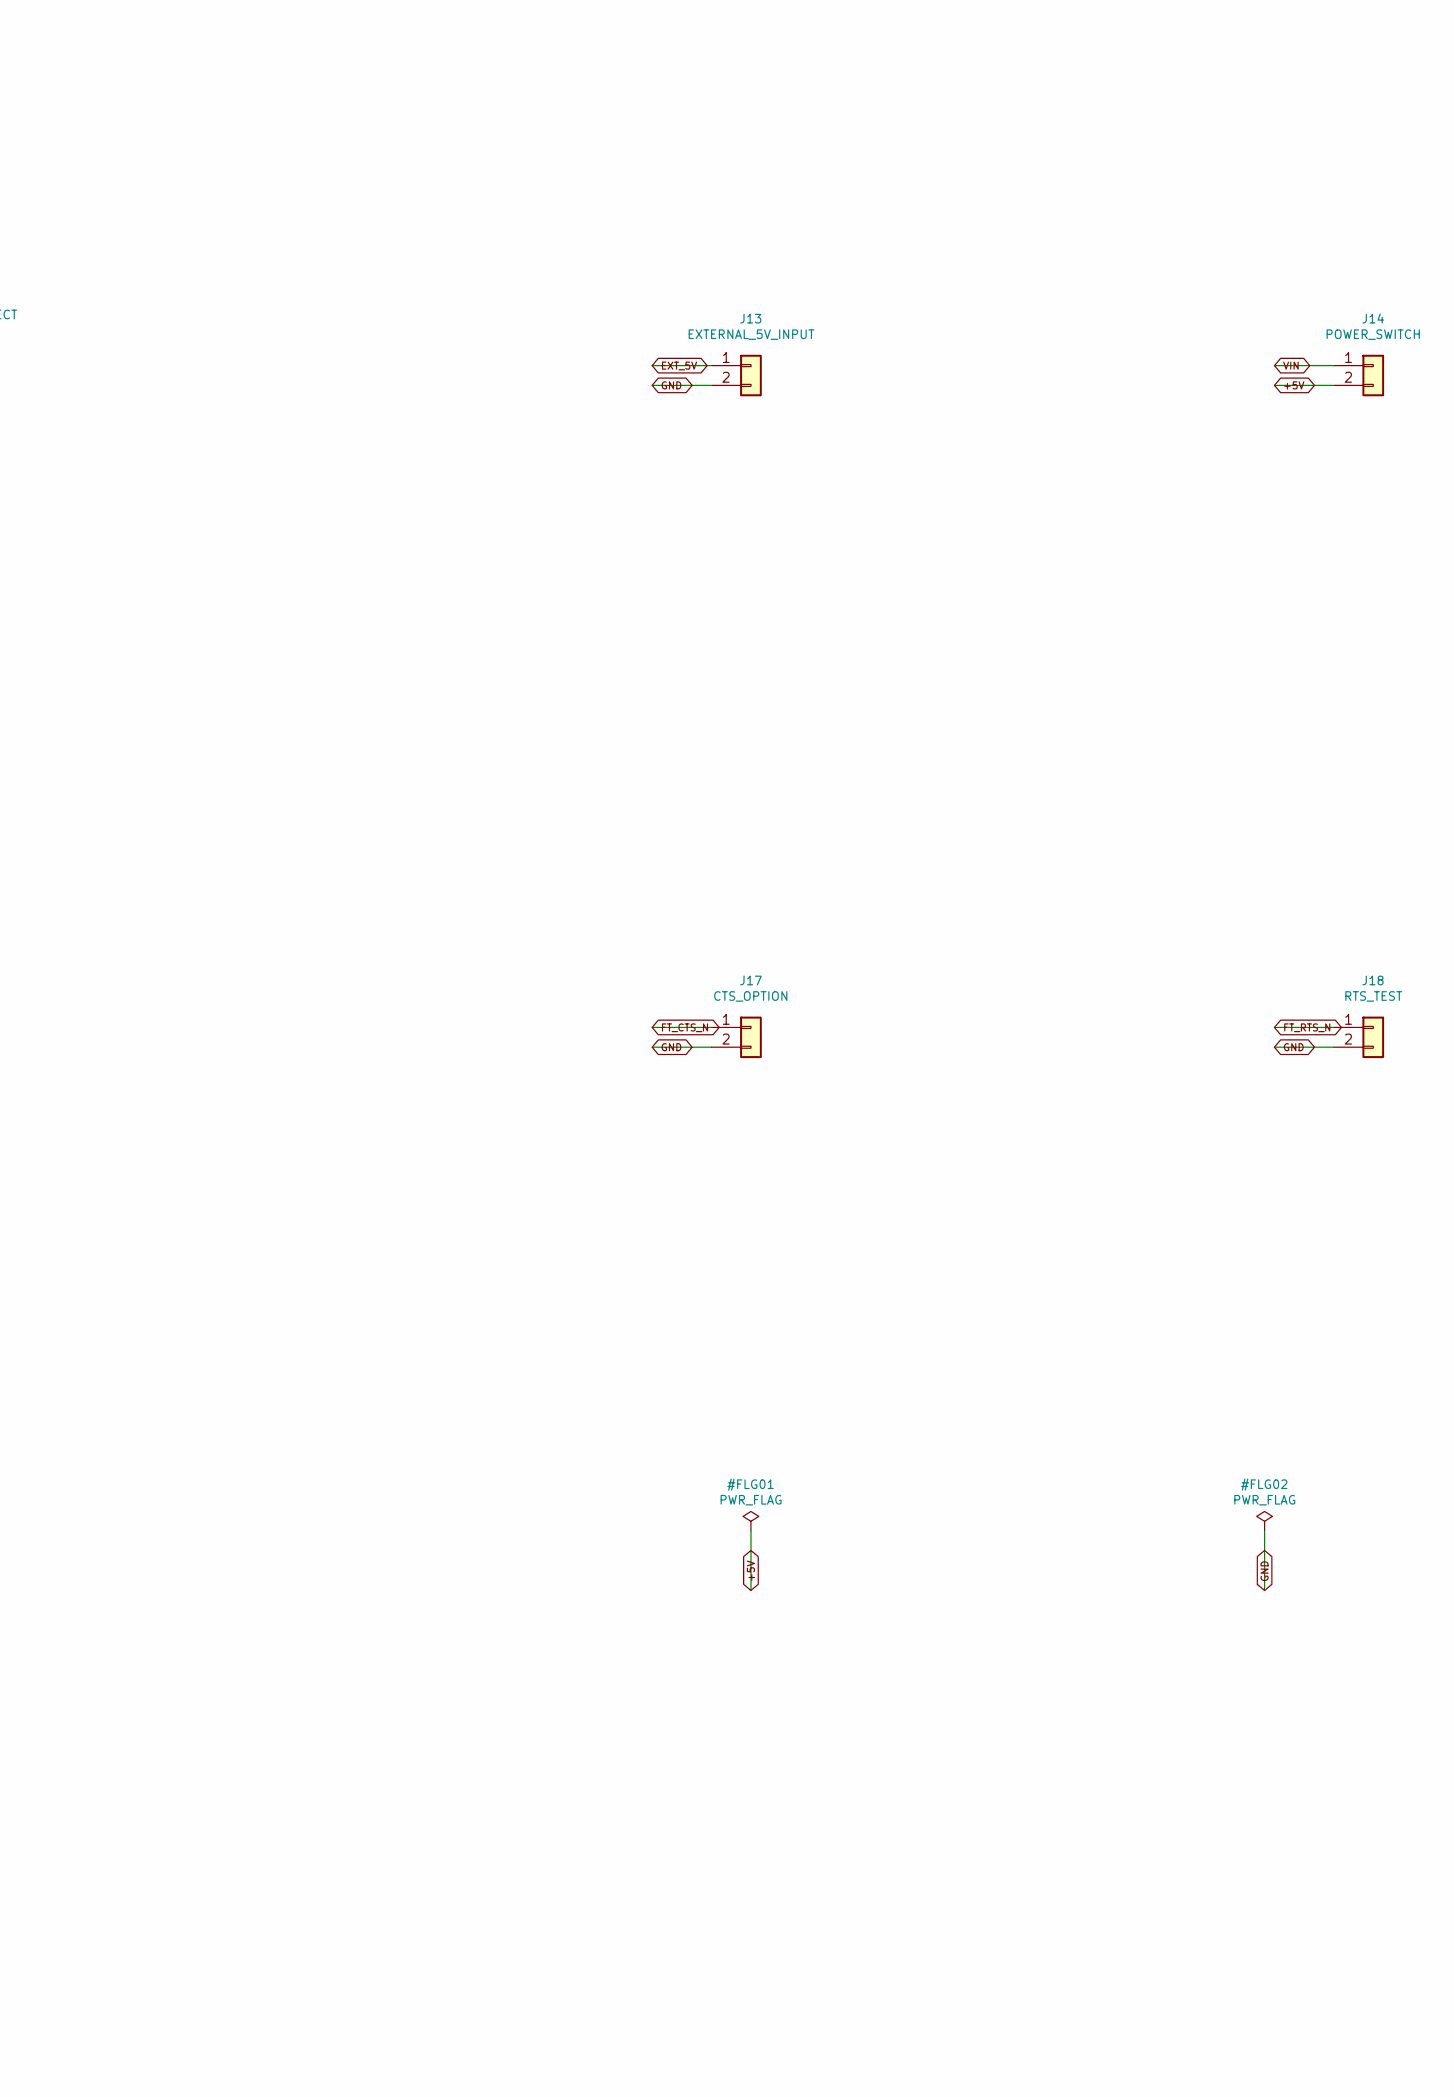
[picture p14: schematic 05_Power_Serial.kicad_sch, part in row 1, column 2]

Parts:
C12: 47uF 16V; CP_Radial_D5.0mm_P2.00mm
C13: 100nF; C_Disc_D5.0mm_W2.5mm_P5.00mm
J11: FT232_CABLE_6; PinHeader_1x06_P2.54mm_Vertical
J12: POWER_SOURCE_SELECT; PinHeader_1x03_P2.54mm_Vertical
J13: EXTERNAL_5V_INPUT; PinHeader_1x02_P2.54mm_Vertical
J14: POWER_SWITCH; PinHeader_1x02_P2.54mm_Vertical
J15: RX_LINK_REVIEW; PinHeader_1x02_P2.54mm_Vertical
J16: TX_LINK_REVIEW; PinHeader_1x02_P2.54mm_Vertical
J17: CTS_OPTION; PinHeader_1x02_P2.54mm_Vertical
J18: RTS_TEST; PinHeader_1x02_P2.54mm_Vertical

Connections:
+5V: C12.1, C13.1, J14.2
EXT_5V: J12.3, J13.1
FT_CTS_N: J11.2, J17.1
FT_RTS_N: J11.6, J18.1
FT_RX: J11.5, J16.2
FT_TX: J11.4, J15.1
GND: C12.2, C13.2, J11.1, J13.2, J17.2, J18.2
SER_RX: J15.2
SER_TX: J16.1
USB_CABLE_5V: J11.3, J12.1
VIN: J12.2, J14.1

Notes on the sheet:
POWER + SERIAL — EXPLICIT PCB REVIEW ITEMS, NOT A VERIFIED POWER PATH
OPEN: source ratings/drop, USB configuration/inrush, ON/OFF UART back-power isolation and switch behavior.
J15/J16 are visibly OPEN design-review links. This draft does not claim working/isolation-safe serial wiring.
Expected ~300mA core; conservative ~750mA, ~1A with displays (SD/expansion excluded).
