TheSupremeMonkey/AMC-6502/hardware/kicad/06_Bank_Display.kicad_sch

## KiCad design hardware/kicad/06_Bank_Display.kicad_sch (2026-10-24)

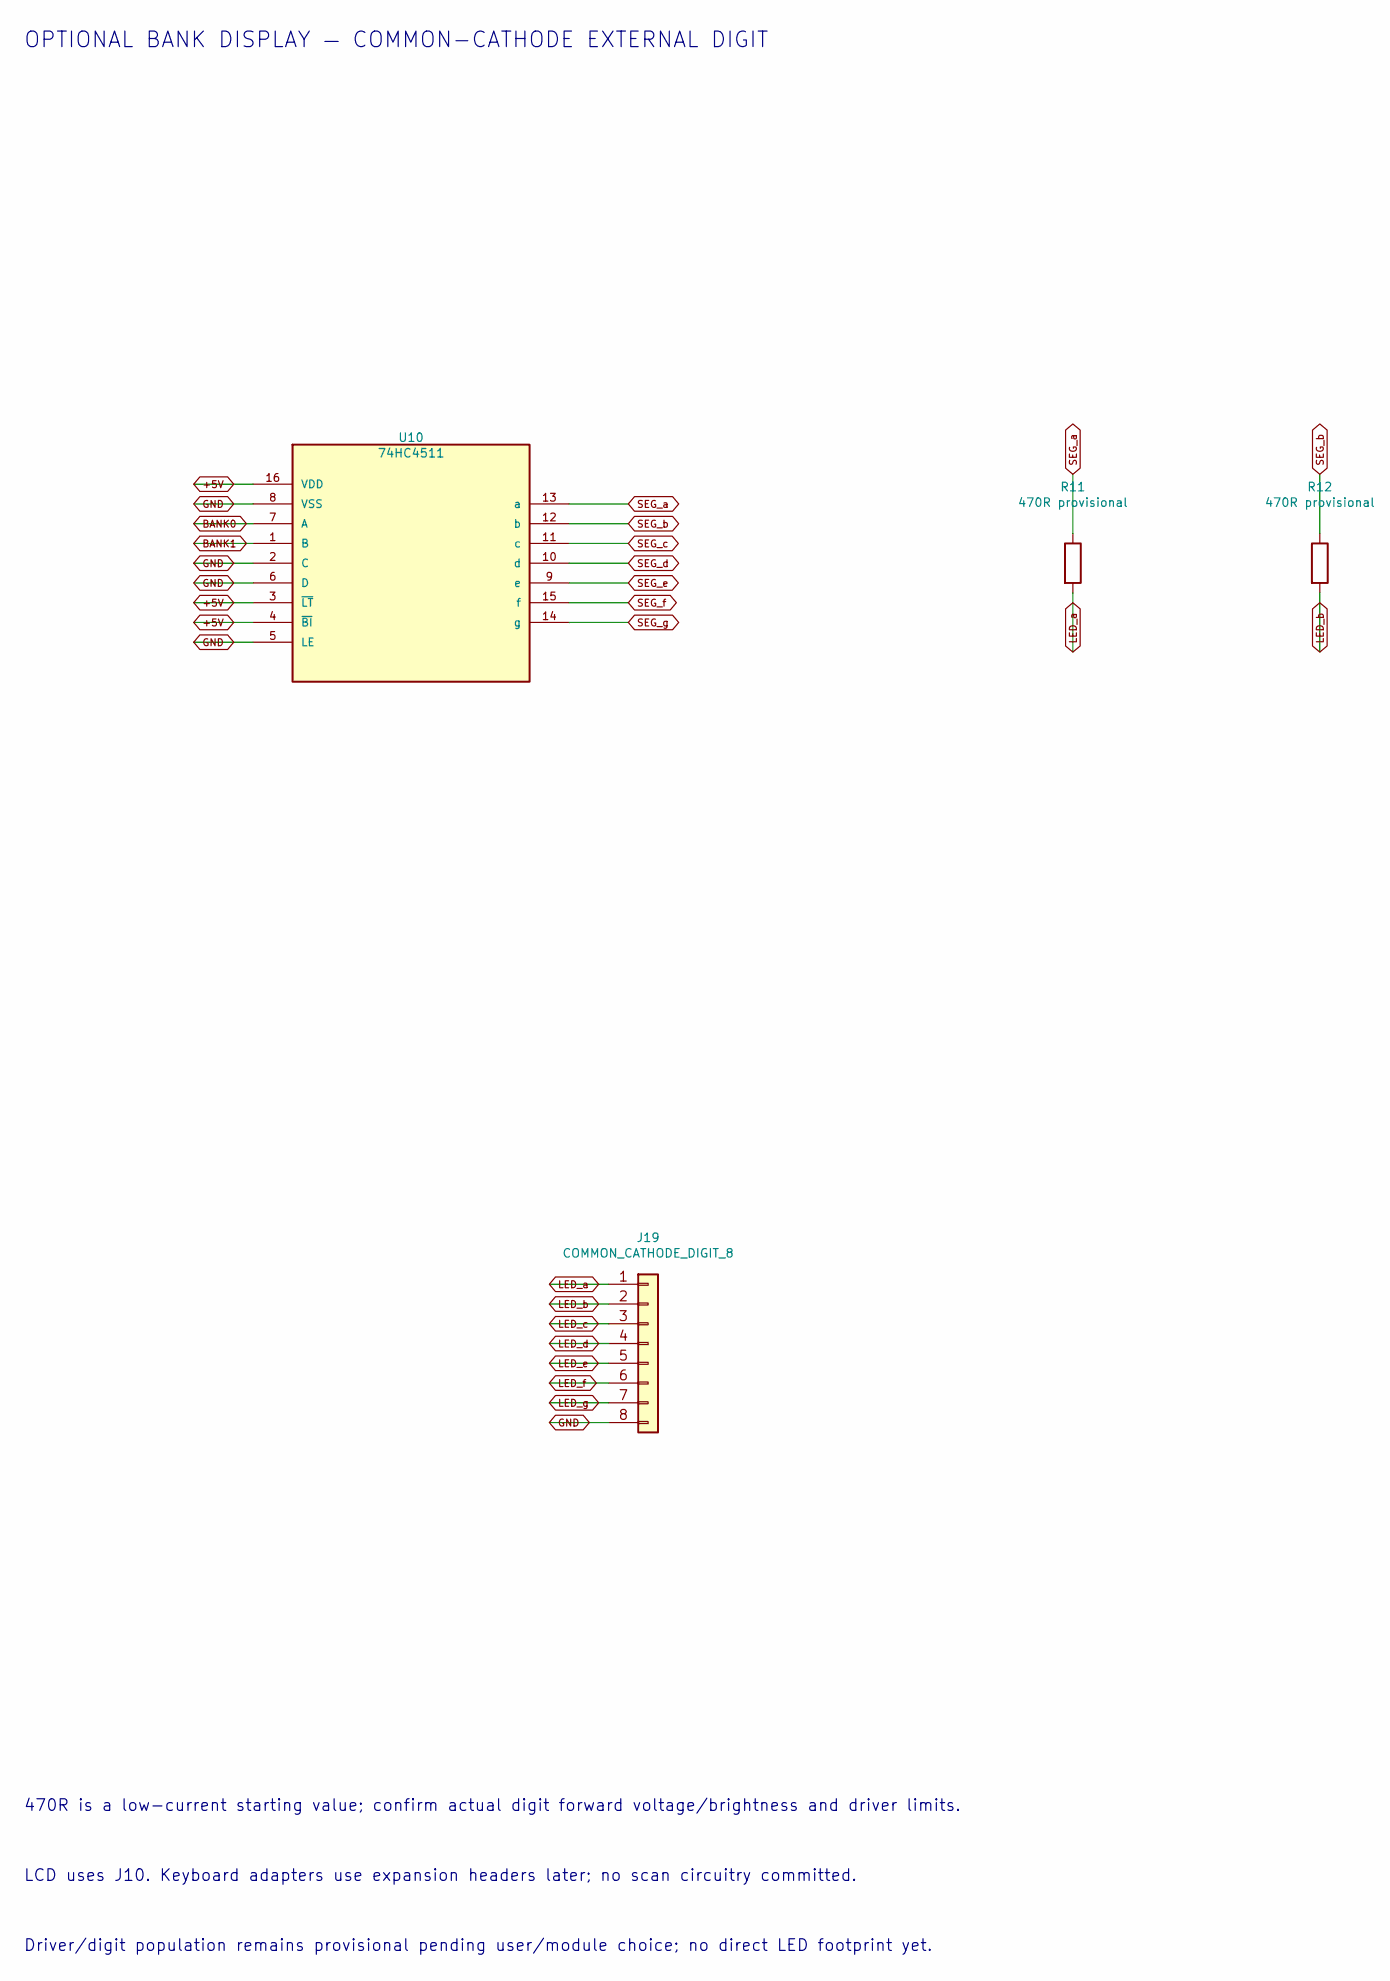
[picture p15: schematic 06_Bank_Display.kicad_sch, part in row 1, column 1]

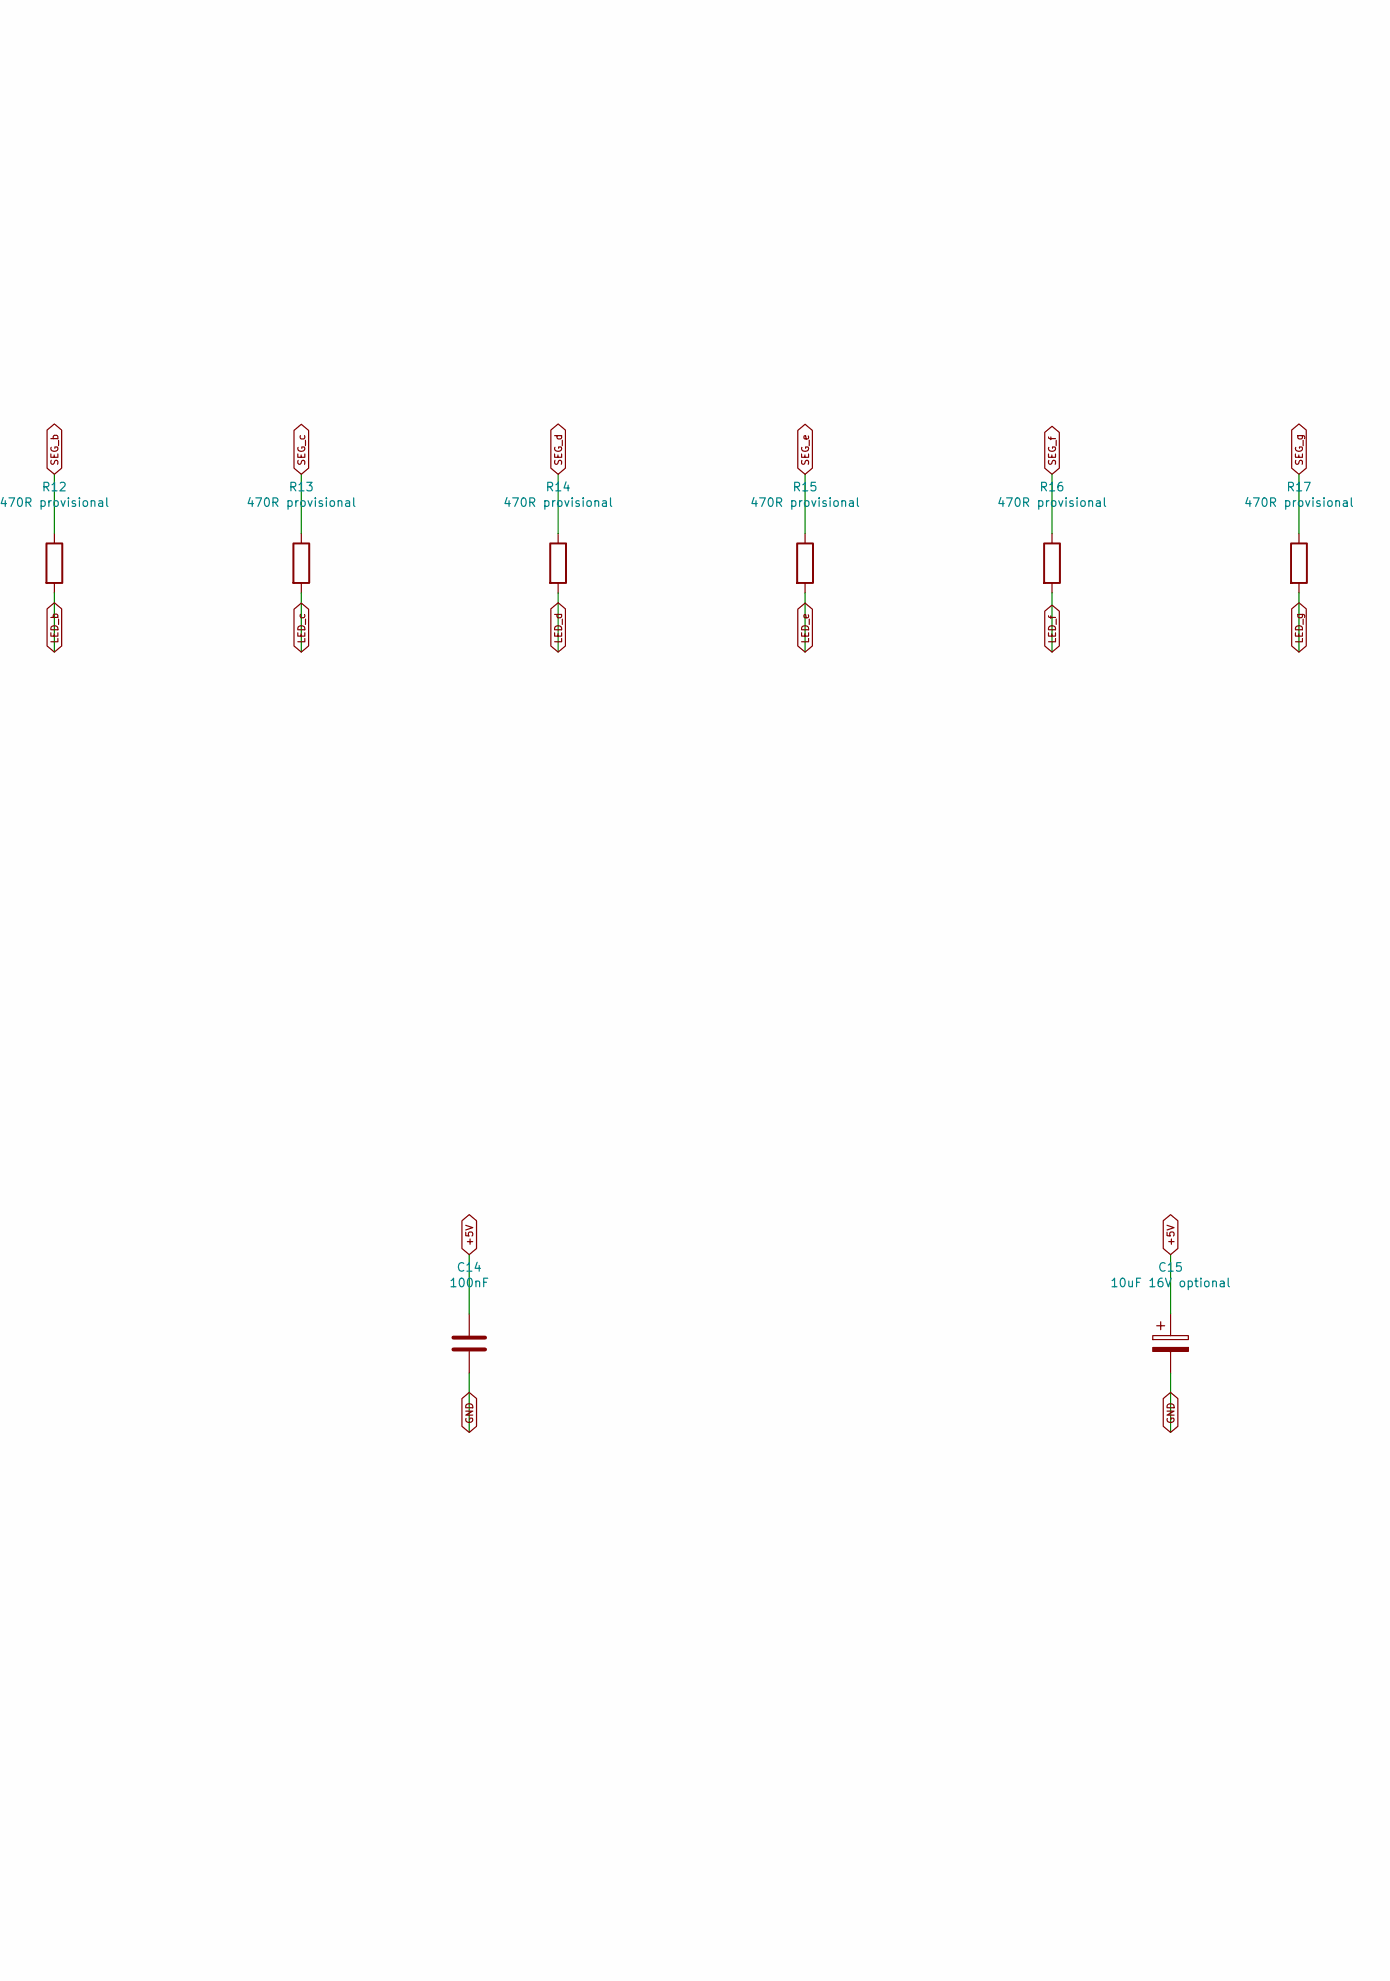
[picture p16: schematic 06_Bank_Display.kicad_sch, part in row 1, column 2]

Parts:
C14: 100nF; C_Disc_D5.0mm_W2.5mm_P5.00mm
C15: 10uF 16V optional; CP_Radial_D5.0mm_P2.00mm
J19: COMMON_CATHODE_DIGIT_8; PinHeader_1x08_P2.54mm_Vertical
R11, R12, R13, R14, R15, R16, R17: 470R provisional; R_Axial_DIN0207_L6.3mm_D2.5mm_P10.16mm_Horizontal
U10: 74HC4511; DIP-16_W7.62mm_Socket

Connections:
+5V: C14.1, C15.1, U10.3 (~LT), U10.4 (~BI), U10.16 (VDD)
BANK0: U10.7 (A)
BANK1: U10.1 (B)
GND: C14.2, C15.2, J19.8, U10.2 (C), U10.5 (LE), U10.6 (D), U10.8 (VSS)
LED_a: J19.1, R11.2
LED_b: J19.2, R12.2
LED_c: J19.3, R13.2
LED_d: J19.4, R14.2
LED_e: J19.5, R15.2
LED_f: J19.6, R16.2
LED_g: J19.7, R17.2
SEG_a: R11.1, U10.13 (a)
SEG_b: R12.1, U10.12 (b)
SEG_c: R13.1, U10.11 (c)
SEG_d: R14.1, U10.10 (d)
SEG_e: R15.1, U10.9 (e)
SEG_f: R16.1, U10.15 (f)
SEG_g: R17.1, U10.14 (g)

Notes on the sheet:
OPTIONAL BANK DISPLAY — COMMON-CATHODE EXTERNAL DIGIT
470R is a low-current starting value; confirm actual digit forward voltage/brightness and driver limits.
LCD uses J10. Keyboard adapters use expansion headers later; no scan circuitry committed.
Driver/digit population remains provisional pending user/module choice; no direct LED footprint yet.
